BrennenJohnston/braille-cylinder-stl-generator-openscad/Braille_Cylinder_STL_Generator.scad

// Braille Cylinder STL Generator (OpenSCAD)
// Generates embossing plates and counter plates for cylindrical objects
//
// =============================================================================
// WHAT THIS MAKES
// =============================================================================
//  • Cylinder Emboss Plate (Raised Dots) — dots on outer cylinder surface
//  • Cylinder Counter Plate (Hemispherical Recesses) — recesses on outer surface
//
//  DOUBLE-SIDED CARD — set double_sided = On to emboss BOTH faces of one
//  card in a single pass between the two cylinders. The same two plates take on
//  paired jobs, and each one then carries raised dots AND recesses:
//  • Cylinder A = the Embossing Plate. The FRONT text as raised dots, plus one
//    recessed seat for every BACK dot the other cylinder raises.
//  • Cylinder B = the Counter Plate. The BACK text as raised dots, plus one
//    recessed seat for every FRONT dot Cylinder A raises.
//  Two things change in this mode. There is NO universal recess grid — every
//  recess is the 1:1 partner of an actual dot, so a seat can never sit under
//  this plate's own raised dot. And the row indicators are always TACTILE (the
//  raised seam arrows), because the paired seats occupy the ground the Visual
//  marker columns would stand on, and a blind user needs the arrow to tell the
//  two cylinders apart. Choosing Visual while double_sided is On is overridden,
//  and the model says so on the console and in red text above the cylinder.
//
// =============================================================================
// BEFORE YOU START
// =============================================================================
//  • Install OpenSCAD and open this .scad file
//  • In OpenSCAD, open View → Customizer to access all parameters
//  • This version requires pre-translated Unicode braille (no automatic translation)
//  • All parameters match the web-based generator UI for consistency
//
// =============================================================================
// TRANSLATE YOUR TEXT (REQUIRED) — BRANAH WORKFLOW
// =============================================================================
//  This OpenSCAD version does NOT include automatic translation. You must:
//  
//  1. Go to https://www.branah.com/braille-translator
//  2. In the options, select your desired braille grade:
//     - Grade 2 (contracted): Recommended for most uses
//     - Grade 1 (uncontracted): For names, emails, or when contractions cause confusion
//  3. Select Unicode Braille output (NOT ASCII Braille)
//  4. Type your English text in the left box
//  5. Copy the braille output (right box showing characters like ⠓⠑⠇⠇⠕)
//  6. In OpenSCAD's Customizer, paste into the Line_1, Line_2, etc. fields
//  7. DOUBLE-SIDED only — the back of the card is translated exactly the
//     same way: same site, same grade, Unicode Braille output. Paste that
//     output into the Back_Line_1, Back_Line_2, … fields under the
//     [Back of Card - Pre-Translated Braille] tab. Back lines obey the same
//     rules as the front — pre-translated Unicode braille only, same cell
//     capacity per row, same row limit — and the same warnings cover them.
//
//  IMPORTANT: If you paste ordinary English letters or see "INVALID CHARACTERS"
//  warning, re-translate on Branah and ensure Unicode Braille is selected.
//
// =============================================================================
// QUICK START GUIDE
// =============================================================================
//  1. Translate your text at https://www.branah.com/braille-translator
//  2. Paste pre-translated braille into Line_1, Line_2, etc.
//  3. Raise grid_rows to at least the number of lines you filled in — only the
//     first grid_rows lines are rendered, and a "TOO MANY LINES" warning tells
//     you when text is being left off. Lines 9 and 10 live under the
//     [More Braille Lines (Advanced)] tab.
//  4. Both cylinders render side by side by default: Cylinder A (the Embossing
//     Plate) on the left, Cylinder B (the Counter Plate) on the right. For one
//     plate, set render_both_plates Off under
//     [Expert Mode - Cylinders to Generate] and choose plate_type.
//  5. Choose dot_shape: Rounded or Cone (affects both plates)
//  6. Adjust dimensions in Expert Mode if needed
//  7. Render (F6) → File → Export → STL
//  8. DOUBLE-SIDED: turn double_sided On and fill the Back_Line fields. One
//     render builds both cylinders; export it as Cylinder_Pair_<your name>.stl.
//     For separate files, set render_both_plates Off and render each
//     plate_type once — export the Embossing Plate as
//     Cylinder_A_<your name>.stl and the Counter Plate as
//     Cylinder_B_<your name>.stl. The console prints the suggested name for
//     whichever plate you are rendering.
//
// =============================================================================
// PARAMETER ORGANIZATION
// =============================================================================
//  The Customizer follows the web-based generator's layout: its sections in
//  its top-down order, under its names, and every dial the web app keeps in
//  Expert Mode under an "Expert Mode - " tab. tests/test_customizer_layout.py
//  pins the order; when the web app's layout changes, this file follows.
//
//  MAIN CONTROLS, the web app's Embosser setup and text entry:
//  • Gears (the integrated_gears switch)
//  • Card Sides (the double_sided switch)
//  • Text Input - Pre-Translated Braille (Line_1 - Line_8)
//  • More Braille Lines (Advanced) (Line_9 - Line_10, the grid_rows maximum)
//  • Back of Card - Pre-Translated Braille (Back_Line_1 - Back_Line_10)
//
//  EXPERT MODE, the web app's Expert Mode submenus in its order:
//  • Expert Mode - Cylinders to Generate (both cylinders by default, or one
//    plate, and the print spacing between them)
//  • Expert Mode - Card Thickness (the 0.4mm and 0.3mm card presets, or Custom)
//  • Expert Mode - Row Indicator Style (Visual markers or the Tactile seam
//    arrow, and the arrow's sizes)
//  • Expert Mode - Shape Selection (dot shapes, indicators)
//  • Expert Mode - Braille Spacing (grid layout, positioning and the TEXT TOO
//    LONG check)
//  • Expert Mode - Braille Dot Adjustments (emboss/counter dimensions)
//  • Expert Mode - Surface Dimensions (including the slicer seam channel)
//
//  OPENSCAD-SPECIFIC, after the web app's sections (no web app dial):
//  • Expert Mode - Card Sides (the two interpoint offsets; the web app keeps
//    them at 1.25 mm)
//  • Expert Mode - Rendering Quality
//
// =============================================================================
// REFERENCES
// =============================================================================
//  [1] Web-based Generator (with automatic translation): 
//      https://github.com/BrennenJohnston/braille-cylinder-stl-generator
//      https://braille-cylinder-stl-generator.vercel.app
//  [2] Branah Braille Translator: https://www.branah.com/braille-translator
//  [3] BANA — Size and Spacing: https://brailleauthority.org/size-and-spacing-braille-characters
//  [4] NLS — Specification 800: https://www.loc.gov/nls/
//  [5] 2010 ADA Standards: https://archive.ada.gov/
//
// =============================================================================
// ACKNOWLEDGMENTS
// =============================================================================
//  This OpenSCAD version is based on the web-based generator by Brennen Johnston.
//  Special thanks to Tobi Weinberg for the substantial time and effort volunteered
//  to help start the original project.
//
//  Original web app powered by Liblouis, an open-source professional braille
//  translator: https://liblouis.io/
// =============================================================================

/* [Gears] */
// Makes each cylinder one solid piece with its top and bottom gears; needs the assets folder beside this file. Fixed gears fit only the Version 1 fixed-gear housing; the standard housing takes the standard cylinders.
integrated_gears = "Off"; // [Off, On]

/* [Card Sides] */
// On embosses both faces of the card in one pass; the back's braille goes in the Back of Card group. Each cylinder then carries raised dots and recesses, and the rows get the tactile arrows.
double_sided = "Off"; // [Off, On]

/* [Text Input - Pre-Translated Braille] */
// Paste Unicode braille characters from www.branah.com/braille-translator
Line_1 = "⠓⠑⠇⠇⠕"; // First line of braille text
Line_2 = "⠺⠕⠗⠇⠙"; // Second line of braille text
Line_3 = ""; // Third line of braille text
Line_4 = ""; // Fourth line of braille text
Line_5 = ""; // Fifth line of braille text
Line_6 = ""; // Sixth line of braille text
Line_7 = ""; // Seventh line of braille text
Line_8 = ""; // Eighth line of braille text

/* [More Braille Lines (Advanced)] */
// Lines 9 and 10 reach the grid_rows maximum of 10. The Customizer cannot add fields on demand, so these live in their own tab rather than lengthening the text input above. Raise grid_rows under [Expert Mode - Braille Spacing] to match, and give the cylinder the height to hold them: 10 rows at the default 10 mm line_spacing needs about 100 mm.
Line_9 = ""; // Ninth line of braille text
Line_10 = ""; // Tenth line of braille text

/* [Back of Card - Pre-Translated Braille] */
// All ten rows live in this tab, unlike the front's 8 + 2 split. That split
// exists to keep the always-visible main text tab at eight fields; this tab is
// opt-in, so splitting it would only send a double-sided user to a second tab -
// one that also holds single-sided fields - to finish one job.

// The back of the card, one row per field, in the same order as the front: Unicode braille, translated the same way. Used only while double sided is On.
Back_Line_1 = ""; // First line of back-of-card braille text
Back_Line_2 = ""; // Second line of back-of-card braille text
Back_Line_3 = ""; // Third line of back-of-card braille text
Back_Line_4 = ""; // Fourth line of back-of-card braille text
Back_Line_5 = ""; // Fifth line of back-of-card braille text
Back_Line_6 = ""; // Sixth line of back-of-card braille text
Back_Line_7 = ""; // Seventh line of back-of-card braille text
Back_Line_8 = ""; // Eighth line of back-of-card braille text
Back_Line_9 = ""; // Ninth line of back-of-card braille text
Back_Line_10 = ""; // Tenth line of back-of-card braille text

/* [Expert Mode - Cylinders to Generate] */
// On builds Cylinder A (left) and Cylinder B (right) in one file, spaced for one print plate. Off builds only the one that plate type names.
render_both_plates = "On"; // [Off, On]
// Choose which plate to generate while render_both_plates above is Off. In DOUBLE-SIDED mode the two names take on the paired roles the web app uses: "Embossing Plate" IS Cylinder A and "Counter Plate" IS Cylinder B, exported as Cylinder_A_*.stl and Cylinder_B_*.stl. Single-sided keeps these names exactly as they are.
plate_type = "Embossing Plate"; // [Embossing Plate, Counter Plate]
// Gap between the two cylinders' surfaces (mm) - PRINT spacing only, not the meshed-gear assembly distance (32.0473 mm axis to axis); a printed pair is separated for assembly anyway. With Integrated Gears On, the gear tips overhang the barrel by 0.71 mm each side, so the tip-to-tip gap comes out about 1.4 mm less than this number.
pair_spacing_mm = 10; // [2:1:50]

/* [Expert Mode - Card Thickness] */
// Preset optimized for card thickness (sets multiple parameters below)
paper_thickness_preset = "0.4mm"; // [0.4mm, 0.3mm, Custom]

/* [Expert Mode - Row Indicator Style] */
// Visual (default): a recessed triangle, plus the optional letter square, at the start of each row. Tactile: a raised arrow on Cylinder A and a matching recess on Cylinder B, found by touch; uses no braille cells.
indicator_mode = "Visual"; // [Visual, Tactile]
// Tactile only: indicator width measured around the cylinder (mm)
tactile_indicator_width = 4.0; // [2:0.1:10]
// Tactile only: indicator length measured along the cylinder axis (mm). The default is long enough for a fingertip to read the direction of the point in one pass; at the 10 mm default line_spacing it also means each row's arrow meets the base of the one above.
tactile_indicator_length = 10.0; // [2:0.1:15]
// Tactile only: how far the embossing plate's arrow stands proud of the surface (mm). Keep this BELOW the braille dot height so the dots — not the indicator — carry the rolling pressure. It also sets the wall: a deeper raise means a deeper counter-plate recess, and the material left between that recess floor and the polygonal cutout gets thinner. 1.2 mm is the printable floor, and the model warns on the console and in red 3D text below it.
tactile_indicator_raise = 0.5; // [0:0.1:2]
// Tactile only: outline margin added around the counter plate's recess (mm), so the arrow still enters the recess when the two cylinders are slightly misaligned.
tactile_recess_clearance = 0.2; // [0:0.05:1]
// Tactile only: counter recess depth added on top of the arrow raise (mm). 0 = exact same-depth nesting. Large values thin the wall between the recess and the polygonal cutout.
tactile_recess_extra_depth = 0.2; // [0:0.05:1]

/* [Expert Mode - Shape Selection] */
// Braille Dot Shape (Emboss and Counter) - affects both plate types (Rounded is the default for the 0.4mm and 0.3mm presets)
dot_shape = "Rounded"; // [Rounded, Cone]
// Indicator Letters (Emboss and Counter) - VISUAL INDICATOR MODE ONLY (Tactile mode has no marker cells and ignores this). Square marker cutout next to the alignment triangle. Off frees 1 cell per row for braille text; the triangle alignment indicators are always included (they are critical to the mechanical device the cylinder mounts into).
indicators = "On"; // [On, Off]

/* [Expert Mode - Braille Spacing] */
// --- Braille Dimensions ---

// Text capacity in braille cells per row (matches the web app default of 13 text cells; in Visual indicator mode, 2 extra marker cells are added when Indicator Letters are On, or 1 extra cell for the always-present alignment triangle when Off — up to 14 text cells fit the default cylinder with Indicator Letters Off. Tactile indicator mode adds no marker cells, so 14 text cells fit the default cylinder, but a 90 mm card loaded at the alignment arrow holds only 13 - 14 run off its end, and the model says so; 15 leaves too little seam gap for the indicator)
grid_columns = 13; // [1:1:20]
// Number of lines of braille
grid_rows = 4; // [1:1:10]
// Horizontal spacing between cells (mm)
cell_spacing = 6.5; // [2:0.1:15]
// Vertical spacing between lines (mm)
line_spacing = 10.0; // [5:0.1:25]
// Spacing between dots within a cell (mm)
dot_spacing = 2.5; // [1:0.1:5]

// --- Braille Positioning ---

// Vertical adjustment of braille pattern (mm). Note: on a cylinder, X = angular wrap around the seam — a linear "X adjust" has no useful meaning, so only the vertical adjust is exposed.
braille_y_adjust = 0.0; // [-10:0.1:10]
// Show TEXT TOO LONG warning and clip rows to the cell capacity. Off = render every pasted character (rows may crowd the seam).
text_limit_check = "On"; // [On, Off]

/* [Expert Mode - Braille Dot Adjustments] */
// --- Embossing Braille Dot Dimensions (Rounded Shape) ---

// Rounded dot base diameter (cone base) (mm)
rounded_dot_base_diameter = 1.5; // [0.5:0.1:3]
// Rounded dot base height (cone height) (mm)
rounded_dot_base_height = 0.5; // [0:0.1:2]
// Rounded dome diameter (linked to cone flat top) (mm)
rounded_dot_dome_diameter = 1.0; // [0.5:0.1:3]
// Rounded dot dome height (mm)
rounded_dot_dome_height = 0.5; // [0.1:0.1:2]

// --- Embossing Braille Dot Dimensions (Cone Shape) ---

// Cone dot base diameter (mm)
emboss_dot_base_diameter = 1.5; // [0.5:0.1:3]
// Cone dot height (mm)
emboss_dot_height = 0.8; // [0.3:0.1:2]
// Cone dot flat hat diameter (mm)
emboss_dot_flat_hat = 0.4; // [0.1:0.1:2]

// --- Counter Braille Recessed Dot Dimensions (Rounded Shape / Bowl) ---

// Bowl recess base diameter (mm)
bowl_counter_dot_base_diameter = 1.8; // [0.5:0.1:5]
// Bowl recess depth (mm)
counter_dot_depth = 0.8; // [0.1:0.1:2]

// --- Counter Braille Recessed Dot Dimensions (Cone Shape) ---

// Cone recess base diameter (mm)
cone_counter_dot_base_diameter = 1.9; // [0.5:0.1:3]
// Cone recess height (mm)
cone_counter_dot_height = 0.7; // [0.3:0.1:2]
// Cone recess flat hat diameter (mm)
cone_counter_dot_flat_hat = 1.0; // [0.1:0.1:2]

/* [Expert Mode - Surface Dimensions] */
// Cylinder outer diameter in mm
cylinder_diameter_mm = 30.8; // [10:0.1:100]
// Cylinder height in mm
cylinder_height_mm = 52; // [20:1:150]
// Polygonal cutout circumscribed radius (0 = no cutout)
polygon_cutout_radius_mm = 13.0; // [0:0.1:50]
// Number of sides/points for polygonal cutout
polygon_cutout_points = 12; // [3:1:24]
// Seam offset (degrees) — Turns the polygonal cutout around the cylinder's axis. The braille does not move.
seam_offset_degrees = 0.0; // [0:1:360]

// Slicer seam channel (OpenSCAD parity plan phase O1, 2026-09-21; web decisions
// D-1, D-2, D-13..D-15). Size is not a dial: the six SEAM_CHANNEL_* constants
// below the sync marker mirror the web generator's app/geometry_spec.py and
// tests/test_seam_channel_scad.py diffs them. The description below is the
// web generator's note for the same switch (its string S-C1), kept identical.

// A shallow groove beside the row markers where the slicer hides its layer seam, keeping it off the dots. Turn Off for a plain surface.
seam_channel = "On"; // [On, Off]

/* [Expert Mode - Card Sides] */
// How far the back grid is shifted from the front grid, so a front dot and a back dot never land on the same patch of paper and flatten each other. The shift is diagonal: this is the part measured AROUND the cylinder (mm). The 1.25 / 1.25 default is the industry interpoint offset and the value the printed pairs were validated at; the 1.15-1.35 range is enforced, and a value outside it stops the render.
interpoint_offset_x_mm = 1.25; // [1.15:0.01:1.35]
// The other half of the same diagonal shift, measured ALONG the cylinder axis (mm) - back rows sit this far above the front rows.
interpoint_offset_y_mm = 1.25; // [1.15:0.01:1.35]

/* [Expert Mode - Rendering Quality] */
// Sphere quality for rounded shapes
render_quality = "Medium"; // [Low, Medium, High]
// Cone segments for cone shapes (8-32 range recommended)
cone_segments = 16; // [8:1:64] Number of segments for cone shapes

/* [Hidden] */
$fn = 32; // Resolution for curved surfaces

// Mathematical constants
PI = 3.14159265359;

// Preset value tables (PRESET_04, PRESET_03) and the preset_value() lookup
// helper live in presets.scad. Edit that file to change preset values.
include <presets.scad>;

// =============================================================================
// DOUBLE-SIDED (INTERPOINT) MATH
// =============================================================================
//
// Double-sided ("interpoint") mode embosses BOTH faces of one card in a single
// pass between two counter-rotating cylinders. Each cylinder then carries raised
// dots (its own face's braille) AND recesses (to receive the other cylinder's
// dots) on the same surface. The back grid is shifted diagonally - the industry
// "interpoint" offset - so a front dot and a back dot never land on the same
// patch of paper and flatten each other.
//
// This section is the MATH: constants, pure functions, self-checks and range
// guards. The geometry that reads them lives further down, in
// ds_back_placements() and the two plate modules. The user-facing controls -
// `double_sided`, `Back_Line_1..10` and the two interpoint offsets - are in the
// [Card Sides], [Back of Card - Pre-Translated Braille] and
// [Expert Mode - Card Sides] Customizer tabs near the top of this file; the gate
// defaults to "Off", and with it Off nothing here changes a single byte of the
// rendered model.
//
// Ported from the web generator's app/geometry/interpoint.py, which stays the
// authoritative implementation. The numbers are the approved 2026-08-16
// interpoint research decisions D1/D2/D3, recorded next to each constant.
//
// PLACEMENT: this block sits ABOVE the BACKWARD COMPATIBILITY marker on purpose.
// Everything from that marker to EOF must stay byte-identical to the MakerWorld
// flattened build (tests/test_makerworld_sync.py), and that build is re-flattened
// in its own phase. Anything added below the marker breaks that guard - which is
// also why the Customizer tabs above hold the parameters, and this block holds
// only what derives from them.

/* [Hidden] */
// Print the self-check echoes below. Off in normal renders so scripts\scad-check.ps1
// stays quiet; tests/test_interpoint_math_scad.py renders with this On. A test
// hook, not a user control, so it stays out of the Customizer.
ds_self_check = false;

// Normalized gate for the `double_sided` dropdown declared in the
// [Card Sides] tab. Accepts the Customizer's "On"/"Off" and the
// lowercase "on"/"off" the test system passes with -D, the same way plate_type
// and dot_shape accept both the label and a lowercase form. Declared here rather
// than beside is_emboss_plate / tactile_on in CALCULATED VALUES because that
// section lives past the MakerWorld sync marker.
ds_on = (double_sided == "On") || (double_sided == "on");

// Normalized gate for the `integrated_gears` dropdown, read exactly the way
// ds_on reads its own: the Customizer sends "On"/"Off" and the test system
// passes lowercase with -D. Deliberately NOT a preset-owned key, so -D reaches
// it headlessly (a -D on a preset-owned key silently loses and the render still
// looks fine).
gears_on = (integrated_gears == "On") || (integrated_gears == "on");

// Gear mode only: grow the RAISED tactile arrow's outline by 5 um. At the
// default 10 mm indicator length on 10 mm line spacing each arrow's apex
// touches the next arrow's base exactly, and float32 STL rounding welds that
// tangency into a non-manifold pinch edge - which would break the watertight
// one-piece roller. Physically negligible: 2.5% of the recess nesting
// clearance, far below print accuracy. Off, the outline is untouched, so
// existing exports keep the tangency they ship with.
GEAR_ARROW_WELD_MM = 0.005;

// Back-face counterpart of _all_lines, under the same contract: the single
// source of truth for the back content, so no geometry ever names a Back_Line_N.
_all_back_lines = [Back_Line_1, Back_Line_2, Back_Line_3, Back_Line_4, Back_Line_5,
                   Back_Line_6, Back_Line_7, Back_Line_8, Back_Line_9, Back_Line_10];

// -----------------------------------------------------------------------------
// D1 - THE INTERPOINT OFFSET
// -----------------------------------------------------------------------------
// The back grid sits 1.25 mm diagonally from the front grid. Source: US Patent
// 5,527,117 (Roy, Impact Devices, 1996). Sweeping the fully-populated
// 2.5 / 6.5 / 10.0 lattice confirms the diagonal is the optimum: it maximises the
// smallest front-to-back centre distance, at 1.767767 mm.
DS_OFFSET_MIN_MM = 1.15;  // smallest offset the guards below accept, mm
DS_OFFSET_MAX_MM = 1.35;  // largest offset the guards below accept, mm
// The peak of that sweep, and the default both offset sliders ship at. Clearance
// falls off SYMMETRICALLY either side of it - 1.15 and 1.35 measure the same
// 1.626 mm - so "move back toward this number" is the fix whichever end of the
// range a user has strayed to. Named here so the guard message below cannot
// drift from the value the sliders actually default to.
DS_OFFSET_OPTIMUM_MM = 1.25;

// -----------------------------------------------------------------------------
// D3 - WHICH WAY THE BACK GRID SHIFTS
// -----------------------------------------------------------------------------
// +1 = the back grid slides toward the END of the line; its features land LEFT
// of Cylinder A's raised arrows, seen from outside the cylinder with the top up.
// Physically confirmed 2026-08. If a printed pair ever crowds the unexpected
// side of the arrow, FLIP THIS SIGN FIRST - no clearance number can catch a
// wrong choice, because both signs measure exactly the same distances (the set
// of front-minus-back difference vectors already holds every vector and its
// negative).
DS_BACK_DIRECTION = 1;

// -----------------------------------------------------------------------------
// D2 - DOUBLE-SIDED FOOTPRINTS, "OPTION B"
// -----------------------------------------------------------------------------
// Double-sided needs smaller dots than single-sided, because raised dots and
// recesses now share one surface. At the shipped single-sided sizes only
// 0.118 mm of material is left between neighbours - below the 0.34 mm a 0.4 mm
// nozzle can print. Single-sided keeps today's sizes.
//
// These ship FIXED - no Customizer dials (2026-08-16) - as TWO packages keyed
// to paper_thickness_preset (Brennen 2026-08-20, research memory FD-8/FD-9):
// the print matrix showed one footprint cannot serve both card stocks. "0.3mm"
// is Option B, validated on 0.3 mm stock 2026-08-17 (nominal gap 0.518);
// anything else - the "0.4mm" default, and "Custom", which has no
// double-sided meaning - is Q2, the matrix winner validated on 0.4 mm stock
// 2026-08-20 (nominal gap 0.468, below the 0.50 reliable line BY DESIGN: the
// printed 0.428 mm ridge was measured printing clean). Keep in lockstep with
// the web repo's app/geometry/interpoint.py DS_FOOTPRINTS_BY_PRESET; the
// tests here pin both packages. Die heights above 1.0 mm scrape the
// embosser's cylinder-holder housing - never raise them without Brennen.
//
// There is deliberately NO dial and NO fallback switch. The rejected
// alternative, "Option A" (dot base dia 1.5 with the 1.3 bowl), leaves a
// 0.368 mm ridge - under the 0.50 mm reliable line and close to the 0.34 mm
// floor - and survives only as documented history in the web repo's
// docs/specifications/INTERPOINT_DOUBLE_SIDED_SPECIFICATIONS.md. Reviving it
// would be a new decision, not a setting.
ds_use_03_package = (paper_thickness_preset == "0.3mm");
DS_DOT_BASE_DIA = 1.2;                            // both packages, mm
DS_DOT_BASE_H   = ds_use_03_package ? 0.4 : 0.5;  // raised dot base height, mm
DS_DOT_DOME_DIA = ds_use_03_package ? 0.8 : 1.0;  // dome diameter at the base, mm
DS_DOT_DOME_H   = ds_use_03_package ? 0.4 : 0.5;  // dome height, mm - total dot 0.8 / 1.0
DS_BOWL_DIA     = ds_use_03_package ? 1.3 : 1.4;  // paired recess opening diameter, mm
DS_BOWL_DEPTH   = 0.5;                            // both packages, mm

// Derived from the six numbers above, so editing one of them moves the geometry
// with it and no size is ever written twice.
DS_DOT_HEIGHT = DS_DOT_BASE_H + DS_DOT_DOME_H;   // total raised dot height, mm

// Dome and bowl are both spherical caps: R = (a^2 + h^2) / (2h) for an opening
// radius a and a height/depth h. Same formula the single-sided dot and the
// counter plate's bowl already use.
DS_DOT_DOME_R = ((DS_DOT_DOME_DIA / 2) * (DS_DOT_DOME_DIA / 2) + DS_DOT_DOME_H * DS_DOT_DOME_H)
                / (2 * DS_DOT_DOME_H);
DS_BOWL_R     = ((DS_BOWL_DIA / 2) * (DS_BOWL_DIA / 2) + DS_BOWL_DEPTH * DS_BOWL_DEPTH)
                / (2 * DS_BOWL_DEPTH);

// WHAT THE BOWL ACTUALLY IS, and why DS_BOWL_DEPTH is not its depth.
//
// The bowl's sphere is centred ON the shell surface, not outside it, so the cut
// is a HEMISPHERE of radius DS_BOWL_R:
//
//     printed depth = DS_BOWL_R          (NOT DS_BOWL_DEPTH)
//     printed mouth = 2 * DS_BOWL_R      (NOT DS_BOWL_DIA)
//
// At the 0.3 package's 1.3 / 0.5 that is 0.6725 mm deep and 1.345 mm across; at
// the 0.4 package's 1.4 / 0.5 it is 0.7400 mm deep and 1.480 mm across. DS_BOWL_DIA
// and DS_BOWL_DEPTH are shape inputs to DS_BOWL_R above and nothing more; any sum
// computed from them directly is wrong. Note DS_BOWL_R is MINIMISED at
// DS_BOWL_DEPTH = DS_BOWL_DIA / 2, so over part of the range raising the depth
// makes the printed bowl SHALLOWER (0.5 -> 0.70 goes 0.6725 -> 0.6518 mm).
//
// This matches static/workers/csg-worker-manifold.js in the web repo
// (radialOffset = cylRadius), which is the authoritative convention by Brennen's
// decision of 2026-08-19: it is the geometry that has actually been printed and
// embossed. The web app's own Python renderer, and the SINGLE-SIDED
// counter_recess() below, both use the other convention - centre (R - depth)
// outside the surface, cut exactly the nominal depth. Single-sided is
// deliberately left alone: changing it would move every counter plate in use.

// Printability thresholds for the material left between a raised dot and a
// neighbouring recess on the same surface (Bambu X1C, 0.4 mm nozzle: Arachne
// widens anything from 0.1 to 0.34 mm up to 0.34 mm, and drops anything below
// 0.1 mm entirely). Those Arachne figures justify the FLOOR. They have never
// justified the reliable line.
//
// DS_GAP_RELIABLE is PROVISIONAL at 0.45 (Brennen, 2026-08-23), lowered from
// 0.50 to match the web app. 0.50 had no stated basis in either generator or in
// any spec, and it put the shipped 0.4 package (0.4678 mm nominal) permanently
// in warning in the WEB app - a standing warning an NVDA walkthrough found, and
// the kind that teaches a user to ignore warnings. It is NOT a measured value:
// the two data points that exist (0.4953 and 0.4278 mm printed) BOTH PASSED,
// and two passing samples cannot locate a failure boundary - they prove only
// that it lies below 0.4278. A print test that walks the gap down until the
// ridge visibly fails is what should set this number.
DS_GAP_RELIABLE = 0.45;   // provisional, unmeasured - see above, mm
DS_GAP_FLOOR    = 0.34;   // hard minimum, enforced by the guard below, mm

// The crowding line the PHYSICAL "DOTS TOO CLOSE" text (past the sync marker)
// fires at. ONE line for both packages, since 2026-08-23.
//
// It used to be `ds_use_03_package ? DS_GAP_RELIABLE : DS_GAP_FLOOR` - ratified
// by Brennen 2026-08-20 - because the 0.4 package sat below a 0.50 mm reliable
// line by design, so pointing the warning at that line would have nagged about
// the default package on every render. The split retired the text for the 0.4
// package entirely. With the reliable line re-decided at 0.45 the 0.4 package
// (0.4678 nominal) clears it honestly, so the workaround has nothing left to
// work around, and Brennen chose on 2026-08-23 to drop it so this generator and
// the web app warn at the same number instead of two.
//
// BEHAVIOUR CHANGE for existing users of the 0.4 package: the text can now
// appear in the 0.34-0.45 mm nominal band, where it was previously silent. That
// band is reachable by moving interpoint_offset_x/y_mm away from 1.25.
//
// The assert - and only the assert - measures the printed ridge (FD-11b,
// 2026-08-20); that is unchanged. The warning stays on the nominal figure so it
// keeps reporting the same number as the web app's checkDoubleSidedGap.
DS_GAP_ACCEPTED = DS_GAP_RELIABLE;

// Axial step between the front rows and the back rows: back rows sit 1.25 mm
// higher than front rows. Same number as the interpoint_offset_y_mm default, and
// unused by the maths in this phase - it is the nominal the row placement in a
// later phase builds on.
DS_AXIAL_STEP = 1.25;

// -----------------------------------------------------------------------------
// THE REFERENCE LATTICE THE CLEARANCE SWEEP RUNS ON
// -----------------------------------------------------------------------------
// Mirrors of the canonical grid defaults, not a new source: the same
// 2.5 / 6.5 / 10.0 mm the braille spacing sliders default to. Interpoint offsets
// the back grid; it never re-spaces braille. These are deliberately constants
// rather than reads of active_dot_spacing and friends, so the reported clearance
// is always the documented worst case - the same number interpoint.py reports.
DS_DOT_PITCH  = 2.5;      // dot-to-dot inside one cell, mm
DS_CELL_PITCH = 6.5;      // cell-to-cell along a row, mm
DS_LINE_PITCH = 10.0;     // row-to-row, mm

// Sweep bounds, matching interpoint.py's TACTILE_COLUMNS and GRID_ROWS. The
// answer does not actually depend on them - the closest pair is always inside a
// single cell - but they are pinned so this file and the web repo report the
// same number from the same sweep.
DS_LATTICE_COLS = 14;
DS_LATTICE_ROWS = 4;

// The fixed dot map, [row, col] for dots 1-6. Identical to `dot_positions` in
// the geometry section; declared separately only because that one lives past the
// MakerWorld sync marker. Never reorder either copy.
DS_DOT_MAP = [[0, 0], [1, 0], [2, 0], [0, 1], [1, 1], [2, 1]];

// -----------------------------------------------------------------------------
// PURE FUNCTIONS
// -----------------------------------------------------------------------------

// Every dot position of a fully-populated grid: all six dots of every cell of
// every row, as [x, y] in mm, x along the row and y up the cylinder. This is the
// worst case for same-surface crowding - real text never fills every position,
// but a counter plate's recesses may, and a user can type text that does.
function ds_lattice_points(cols       = DS_LATTICE_COLS,
                           rows       = DS_LATTICE_ROWS,
                           dot_pitch  = DS_DOT_PITCH,
                           cell_pitch = DS_CELL_PITCH,
                           line_pitch = DS_LINE_PITCH) =
    let (col_offsets = [-dot_pitch / 2, dot_pitch / 2],
         row_offsets = [dot_pitch, 0, -dot_pitch])
    [ for (col = [0 : cols - 1])
        for (row = [0 : rows - 1])
          for (d = DS_DOT_MAP)
            [ col * cell_pitch + col_offsets[d[1]],
              -row * line_pitch + row_offsets[d[0]] ] ];

// Smallest centre-to-centre distance, in mm, between a front feature and a back
// one. The back lattice is the front lattice mirrored and then translated, but a
// fully-populated grid is symmetric about its own centre, so the mirror maps it
// onto itself and the worst case reduces to a pure translation by the interpoint
// offset. DS_BACK_DIRECTION is applied so the code says which way the back grid
// goes; it provably cannot change the answer (see D3 above).
function ds_lattice_min_center_distance(offx, offy,
                                        cols       = DS_LATTICE_COLS,
                                        rows       = DS_LATTICE_ROWS,
                                        dot_pitch  = DS_DOT_PITCH,
                                        cell_pitch = DS_CELL_PITCH,
                                        line_pitch = DS_LINE_PITCH) =
    let (pts     = ds_lattice_points(cols, rows, dot_pitch, cell_pitch, line_pitch),
         shift_x = DS_BACK_DIRECTION * offx,
         shift_y = DS_BACK_DIRECTION * offy)
    sqrt(min([ for (b = pts)
                 min([ for (f = pts)
                         let (dx = f[0] - (b[0] + shift_x),
                              dy = f[1] - (b[1] + shift_y))
                         dx * dx + dy * dy ]) ]));

// Material left between a raised dot and its nearest neighbouring recess, in mm.
// Both live on the same cylinder surface: one face's raised dots and the recesses
// that receive the other face's dots. NEGATIVE means the two footprints overlap
// and the printed ridge between them does not exist. Compare against
// DS_GAP_RELIABLE (0.45 mm, provisional) and DS_GAP_FLOOR (0.34 mm).
function ds_same_surface_min_gap(dot_dia, recess_dia, offx, offy,
                                 cols       = DS_LATTICE_COLS,
                                 rows       = DS_LATTICE_ROWS,
                                 dot_pitch  = DS_DOT_PITCH,
                                 cell_pitch = DS_CELL_PITCH,
                                 line_pitch = DS_LINE_PITCH) =
    ds_lattice_min_center_distance(offx, offy, cols, rows, dot_pitch, cell_pitch, line_pitch)
    - (dot_dia + recess_dia) / 2;

// -----------------------------------------------------------------------------
// SELF-CHECKS
// -----------------------------------------------------------------------------
// Values with known answers, so a change to the maths above is caught at
// once instead of silently shifting every clearance. Printed only when
// ds_self_check is true, and independent of double_sided - the functions are
// pure, so they can be checked with the feature Off.
// tests/test_interpoint_math_scad.py renders with -D ds_self_check=true and
// asserts every expected key to +/-0.001 mm.
//   gap_package_03    Option B (dot 1.2, bowl 1.3) - above the reliable line
//   gap_package_04    Q2 (dot 1.2, bowl 1.4) - marginal BY DESIGN; the printed
//                     0.428 mm ridge was measured clean 2026-08-20
//   gap_active        the same gap for the ACTIVE preset's package
//   gap_active_printed  the SAME gap measured on the bowl's PRINTED mouth
//                     (2 * DS_BOWL_R) instead of its nominal diameter. The bowl
//                     is cut as a hemisphere centred on the surface, so its
//                     mouth is wider than DS_BOWL_DIA and the real ridge is
//                     narrower than every gap above it: 0.495 mm for the 0.3
//                     package where the nominal says 0.518, and 0.428 mm for
//                     the 0.4 package where the nominal says 0.468. The
//                     printability ASSERT measures this number (Brennen's
//                     decision 2026-08-20); the DOTS TOO CLOSE text keeps
//                     reporting the nominal, so it stays the same figure the
//                     web app's checkDoubleSidedGap and app/geometry_spec.py
//                     show. Echoed at the fixed 1.25 / 1.25 reference offsets,
//                     like every gap above it - the guard's own live value is
//                     ds_printed_ridge_mm, further down.
//   gap_single_sided  the web app's single-sided sizes - the documented failure
//                     case, below the 0.34 mm floor
//   gap_legacy_cone   the legacy cone footprints - negative, i.e. overlapping
// The four values after them are the derived footprint geometry the paired dot
// and recess are actually built from, echoed so the cut depth this file produces
// can be cited without opening a mesh.
if (ds_self_check) {
    echo("DS_SELFCHECK: every value below is mm");
    echo(str("DS_SELFCHECK lattice_1_25_1_25=", ds_lattice_min_center_distance(1.25, 1.25)));
    echo(str("DS_SELFCHECK lattice_1_25_0=",    ds_lattice_min_center_distance(1.25, 0)));
    echo(str("DS_SELFCHECK gap_package_03=",    ds_same_surface_min_gap(1.2, 1.3, 1.25, 1.25)));
    echo(str("DS_SELFCHECK gap_package_04=",    ds_same_surface_min_gap(1.2, 1.4, 1.25, 1.25)));
    echo(str("DS_SELFCHECK gap_active=",        ds_same_surface_min_gap(DS_DOT_BASE_DIA, DS_BOWL_DIA, 1.25, 1.25)));
    echo(str("DS_SELFCHECK gap_active_printed=", ds_same_surface_min_gap(DS_DOT_BASE_DIA, 2 * DS_BOWL_R, 1.25, 1.25)));
    echo(str("DS_SELFCHECK gap_single_sided=",  ds_same_surface_min_gap(1.5, 1.8, 1.25, 1.25)));
    echo(str("DS_SELFCHECK gap_legacy_cone=",   ds_same_surface_min_gap(1.8, 1.8, 1.25, 1.25)));
    echo(str("DS_SELFCHECK dot_height=",         DS_DOT_HEIGHT));
    echo(str("DS_SELFCHECK dot_dome_r=",         DS_DOT_DOME_R));
    echo(str("DS_SELFCHECK bowl_sphere_r=",      DS_BOWL_R));
    echo(str("DS_SELFCHECK bowl_printed_mouth=",  2 * DS_BOWL_R));
}

// The ridge the printability guard measures, at the user's ACTUAL offsets: the
// material left between a raised dot and its neighbouring recess, using the
// bowl's PRINTED mouth (2 * DS_BOWL_R) rather than its nominal diameter.
//
// Brennen's decision, 2026-08-20: the hard guard measures what actually prints.
// The bowl is cut as a hemisphere centred on the shell surface, so its mouth is
// wider than DS_BOWL_DIA and the nominal figure OVERSTATES the ridge - by
// 0.023 mm for the 0.3 package and 0.040 mm for the 0.4 package. That gap is
// exactly the band where the old nominal guard let through a ridge the printer
// cannot hold. The DOTS TOO CLOSE warning below deliberately still reports the
// nominal, matching the web app's checkDoubleSidedGap and app/geometry_spec.py;
// only the assert moved, so no warning threshold had to be re-decided.
//
// Consequence, measured: with the shipped 0.4 package the renderable offset band
// is 1.19-1.31 mm rather than the slider's full 1.15-1.35. The 0.3 package keeps
// the whole range (its worst case is 0.354 mm, still above the floor). Clearance
// peaks at DS_OFFSET_OPTIMUM_MM and falls off symmetrically, so both ends fail
// together and moving back toward the middle is always the fix.
ds_printed_ridge_mm = ds_on
    ? ds_same_surface_min_gap(DS_DOT_BASE_DIA, 2 * DS_BOWL_R,
                              interpoint_offset_x_mm, interpoint_offset_y_mm)
    : 0;

// -----------------------------------------------------------------------------
// GUARDS
// -----------------------------------------------------------------------------
// Active only when double_sided is On. A failed assert stops the render and
// fails scripts\scad-check.ps1 - that is the point. A pair printed outside these
// ranges will not register, and nothing in a rendered preview would show it.
if (ds_on) {
    assert(interpoint_offset_x_mm >= DS_OFFSET_MIN_MM &&
           interpoint_offset_x_mm <= DS_OFFSET_MAX_MM,
           "interpoint_offset_x_mm outside 1.15-1.35 range");
    assert(interpoint_offset_y_mm >= DS_OFFSET_MIN_MM &&
           interpoint_offset_y_mm <= DS_OFFSET_MAX_MM,
           "interpoint_offset_y_mm outside 1.15-1.35 range");
    assert(ds_printed_ridge_mm >= DS_GAP_FLOOR,
           str("double-sided dots and recesses too close to print: this offset ",
               "leaves only ", round(ds_printed_ridge_mm * 1000) / 1000,
               " mm of material between a raised dot and the recess beside it, ",
               "and ", DS_GAP_FLOOR, " mm is the printable minimum. Clearance is ",
               "widest with both interpoint offsets at ", DS_OFFSET_OPTIMUM_MM,
               " mm and narrows toward either end of the range, so move them ",
               "back toward ", DS_OFFSET_OPTIMUM_MM,
               " mm - or select the 0.3mm card stock preset, which pairs the ",
               "same dot with a smaller bowl and accepts the whole range."));
}

// =============================================================================
// BACKWARD COMPATIBILITY - Test System Parameters
// =============================================================================
// The automated test system passes parameters via -D flags using these names.
// These hidden parameters allow the test system to work without modification.
//
// Usage: openscad -D 'combined_shape="rounded"' -D 'indicator_shapes="on"' ...
//
// IMPORTANT: keep this `/* [Hidden] */` marker so OpenSCAD's Customizer
// never renders these four vars as orphan, uncategorized sliders even if
// a new `/* [Section] */` heading gets inserted above this block later.
/* [Hidden] */
combined_shape = "";         // "rounded" or "cone" (from test system)
indicator_shapes = "";       // "on" or "off" (from test system)
hemisphere_quality = "";     // "low", "medium", "high" (from test system)
shape_type = "";             // "cylinder" (from test system, ignored - cylinder only)

// =============================================================================
// CALCULATED VALUES (Do not modify)
// =============================================================================

// Normalize dropdown selections to internal values
// Support both UI dropdowns (human-friendly) and test system parameters (lowercase)
is_emboss_plate = (plate_type == "positive") ? true :
                  (plate_type == "negative") ? false :
                  (plate_type == "Embossing Plate");

// Both-plates mode: lowercase accepted the way the other toggles
// accept theirs from the test system. While On, plate_type is ignored and
// MAIN RENDERING at the bottom builds both cylinders side by side.
both_on = (render_both_plates == "On") || (render_both_plates == "on");

use_rounded_dots = (combined_shape == "rounded") ? true :
                   (combined_shape == "cone") ? false :
                   (dot_shape == "Rounded");

indicator_on = (indicator_shapes == "on") ? true :
               (indicator_shapes == "off") ? false :
               (indicators == "On");

// Tactile indicator mode replaces the recessed marker columns with a raised
// arrow (emboss) / matching recess (counter) in the seam gap. It supersedes
// `indicator_on`, which only ever gates the Visual letter square.
//
// Double-sided mode is always tactile. Its two cylinders carry 1:1 paired
// recesses across the whole surface, which is exactly where the Visual marker
// columns would sit, and a blind user working a double-sided pair needs the
// seam arrow to tell the two cylinders apart. The web app refuses the
// combination outright; here it is forced, and warned about below.
tactile_on = (indicator_mode == "Tactile") || ds_on;

// Set when that forcing actually overrode a user's choice, so it can be both
// echoed and rendered as 3D warning text.
ds_forced_tactile = ds_on && (indicator_mode != "Tactile");

if (ds_forced_tactile)
    echo(str("WARNING: double_sided is On, so indicator_mode \"", indicator_mode,
             "\" has been overridden and this plate renders with tactile seam ",
             "arrows. Set indicator_mode = Tactile to clear this."));

// Double-sided renders come in pairs, and the two STLs have to be told apart
// after export. The names match the web app's double-sided flow, whose downloads
// are Cylinder_A_*.stl and Cylinder_B_*.stl; single-sided filenames are never
// renamed. Deliberately not a WARNING: it is a hint, and scripts\scad-check.ps1
// treats that token as a failure.
// Gated on !both_on: in both-plates mode one file holds the
// pair, so the pair hint below speaks instead.
if (ds_on && !both_on)
    echo(str("Double-sided: this render is Cylinder ", is_emboss_plate ? "A" : "B",
             " (the ", is_emboss_plate ? "Embossing Plate" : "Counter Plate",
             "). Suggested export filename: Cylinder_", is_emboss_plate ? "A" : "B",
             "_<your name>.stl"));

// Both-plates mode: one render, one file, one suggested name. Deliberately
// not a WARNING - scripts\scad-check.ps1 treats that token as a failure.
if (both_on) {
    echo(str("Both plates: one STL containing Cylinder A / Embossing Plate (left) ",
             "and Cylinder B / Counter Plate (right), surfaces ", pair_spacing_mm,
             " mm apart. Suggested export filename: Cylinder_Pair_<your name>.stl"));
    echo("NOTE: render_both_plates is On, so plate_type is ignored and both cylinders render.");
}

// Material left between a raised dot and its nearest neighbouring recess, both
// of which share this surface in double-sided mode. The 336-point lattice sweep
// behind it is only paid for when the mode is on.
ds_same_surface_gap = ds_on
    ? ds_same_surface_min_gap(DS_DOT_BASE_DIA, DS_BOWL_DIA,
                              interpoint_offset_x_mm, interpoint_offset_y_mm)
    : 0;
// Below DS_GAP_FLOOR the guard in the DOUBLE-SIDED MATH section has already
// stopped the render, so this text only ever speaks in the band between the
// floor and DS_GAP_ACCEPTED. Since 2026-08-23 that is the same line for both
// packages (see the DOUBLE-SIDED MATH section); before then the 0.4 package
// used the floor instead, which retired this text for it entirely.
ds_dots_too_close = ds_on && (ds_same_surface_gap < DS_GAP_ACCEPTED);

// Map render quality to segment counts (support both UI and test system).
//
// The test override is ranked ABOVE the dropdown, not interleaved with it.
// Interleaved - the arms reading `hemisphere_quality == "low" || render_quality
// == "Low"` and so on - the override could not raise quality: with the shipped
// default render_quality "Medium" standing, `hemisphere_quality="high"` fell
// through arm 1, then matched "Medium" in arm 2 and silently rendered at 32.
// The 64 arm was unreachable. "low" and "medium" appeared to work only by
// accident ("medium" collides with the default's own answer), so the bug bit
// exactly the one value that disagrees with the default.
quality_fn = (hemisphere_quality == "low")    ? 24 :
             (hemisphere_quality == "medium") ? 32 :
             (hemisphere_quality == "high")   ? 64 :
             (render_quality == "Low")        ? 24 :
             (render_quality == "High")       ? 64 : 32;

// =============================================================================
// PRESET ROUTING - Select preset vs. custom values
// =============================================================================
// Each `_preset_*` variable routes between the matching preset table entry
// (see presets.scad) and the user's slider value. If `paper_thickness_preset`
// is "0.4mm" or "0.3mm", the table value wins; otherwise the slider value
// (third argument) is used.

// Spacing parameters
_preset_grid_columns                   = preset_value(paper_thickness_preset, "grid_columns",                   grid_columns);
_preset_grid_rows                      = preset_value(paper_thickness_preset, "grid_rows",                      grid_rows);
_preset_cell_spacing                   = preset_value(paper_thickness_preset, "cell_spacing",                   cell_spacing);
_preset_line_spacing                   = preset_value(paper_thickness_preset, "line_spacing",                   line_spacing);
_preset_dot_spacing                    = preset_value(paper_thickness_preset, "dot_spacing",                    dot_spacing);
_preset_braille_y_adjust               = preset_value(paper_thickness_preset, "braille_y_adjust",               braille_y_adjust);

// Emboss Rounded parameters
_preset_rounded_dot_base_diameter      = preset_value(paper_thickness_preset, "rounded_dot_base_diameter",      rounded_dot_base_diameter);
_preset_rounded_dot_base_height        = preset_value(paper_thickness_preset, "rounded_dot_base_height",        rounded_dot_base_height);
_preset_rounded_dot_dome_diameter      = preset_value(paper_thickness_preset, "rounded_dot_dome_diameter",      rounded_dot_dome_diameter);
_preset_rounded_dot_dome_height        = preset_value(paper_thickness_preset, "rounded_dot_dome_height",        rounded_dot_dome_height);

// Emboss Cone parameters
_preset_emboss_dot_base_diameter       = preset_value(paper_thickness_preset, "emboss_dot_base_diameter",       emboss_dot_base_diameter);
_preset_emboss_dot_height              = preset_value(paper_thickness_preset, "emboss_dot_height",              emboss_dot_height);
_preset_emboss_dot_flat_hat            = preset_value(paper_thickness_preset, "emboss_dot_flat_hat",            emboss_dot_flat_hat);

// Counter Bowl parameters
_preset_bowl_counter_dot_base_diameter = preset_value(paper_thickness_preset, "bowl_counter_dot_base_diameter", bowl_counter_dot_base_diameter);
_preset_counter_dot_depth              = preset_value(paper_thickness_preset, "counter_dot_depth",              counter_dot_depth);

// Counter Cone parameters
_preset_cone_counter_dot_base_diameter = preset_value(paper_thickness_preset, "cone_counter_dot_base_diameter", cone_counter_dot_base_diameter);
_preset_cone_counter_dot_height        = preset_value(paper_thickness_preset, "cone_counter_dot_height",        cone_counter_dot_height);
_preset_cone_counter_dot_flat_hat      = preset_value(paper_thickness_preset, "cone_counter_dot_flat_hat",      cone_counter_dot_flat_hat);

// Cylinder parameters
_preset_cylinder_diameter_mm           = preset_value(paper_thickness_preset, "cylinder_diameter_mm",           cylinder_diameter_mm);
_preset_cylinder_height_mm             = preset_value(paper_thickness_preset, "cylinder_height_mm",             cylinder_height_mm);
_preset_polygon_cutout_radius_mm       = preset_value(paper_thickness_preset, "polygon_cutout_radius_mm",       polygon_cutout_radius_mm);
_preset_polygon_cutout_points          = preset_value(paper_thickness_preset, "polygon_cutout_points",          polygon_cutout_points);
_preset_seam_offset_degrees            = preset_value(paper_thickness_preset, "seam_offset_degrees",            seam_offset_degrees);

// =============================================================================
// ACTIVE PARAMETERS - Final values used by geometry
// =============================================================================
// These variables provide the final parameter values used by the geometry code.
// They incorporate both preset routing (above) and shape-based routing (rounded vs cone).

// Active emboss dot parameters (based on shape selection, using preset-routed values)
// Note: cone/rounded emboss modules consume the underlying _preset_* constants
// directly; only the composite height is needed at this layer.
// Double-sided ships its own FIXED footprint (Option B):
// raised dots and recesses now share one surface, and at the single-sided sizes
// only 0.118 mm of material would be left between neighbours. So the ds gate
// wins over both the shape selection and the paper-thickness preset, and no
// dial reaches it. `braille_dot_for_plate` below routes the matching solid.
active_emboss_height = ds_on ? DS_DOT_HEIGHT :
                       use_rounded_dots ? (_preset_rounded_dot_base_height + _preset_rounded_dot_dome_height) : _preset_emboss_dot_height;

// Active counter dot parameters (based on shape selection, using preset-routed values)
active_counter_height = use_rounded_dots ? _preset_counter_dot_depth : _preset_cone_counter_dot_height;

// Active spacing parameters (pass through from preset routing)
active_grid_columns = _preset_grid_columns;
active_grid_rows = _preset_grid_rows;
active_cell_spacing = _preset_cell_spacing;
active_line_spacing = _preset_line_spacing;
active_dot_spacing = _preset_dot_spacing;
active_braille_y_adjust = _preset_braille_y_adjust;

// Active cylinder parameters (pass through from preset routing)
active_cylinder_diameter_mm = _preset_cylinder_diameter_mm;
active_cylinder_height_mm = _preset_cylinder_height_mm;
active_polygon_cutout_radius_mm = _preset_polygon_cutout_radius_mm;
active_polygon_cutout_points = _preset_polygon_cutout_points;
active_seam_offset_degrees = _preset_seam_offset_degrees;

// Both-plates mode, PRINT layout only: centres one diameter plus the gap
// apart puts the barrel surfaces exactly pair_spacing_mm apart. Not related
// to the 32.0473 mm meshed-gear assembly distance. Brennen chose the
// barrel-based measure on 2026-08-25 (gear tips overhang it; the slider
// comment carries that caveat).
pair_center_offset_mm = active_cylinder_diameter_mm + pair_spacing_mm;

// -----------------------------------------------------------------------------
// TACTILE INDICATOR CONSTANTS
// -----------------------------------------------------------------------------
// Declared here, ahead of the grid maths, because OpenSCAD evaluates top-level
// assignments strictly in source order — a constant used by a calculated value
// must already exist at that point. (Constants consumed only inside modules,
// like INDICATOR_OVERCUT below, can be declared later.)

// Clear zone required either side of the indicator, on top of its own width,
// before the seam gap is considered too tight (2 mm dot zone per neighbouring
// cell plus 1 mm of margin).
TACTILE_MIN_GAP_MARGIN = 5.0;

// The card a tactile row has to fit, measured from the alignment arrow where
// its leading edge sits (web decision D-T3, 2026-09-21): the 90 mm business
// card the web generator carries as card_width. A constant, not a dial - the
// web app reads its own field.
CARD_LENGTH_MM = 90;

// Tactile mode's seam channel runs down the arrow column itself (web decision
// D-T6, 2026-09-21), the full height (D-T7: Brennen's print showed the slicer
// choosing dots wherever the groove stopped), and on the emboss plate it steps
// round each raised arrow on the first-cell side instead of running through
// it (D-T8, 2026-09-22: the V through the arrow took its point and made the
// triangle less distinguishable by touch). It leaves the column at this slant
// from the axis, rounds the base corner, runs beside the long side and rounds
// the tip back to the column, its mouth SEAM_CHANNEL_MARGIN_MM clear of the
// arrow; the slant, not a run along the base, keeps a V on every printed
// layer. The round corners are chords of at most the arc step, set outside
// the circle, and a sideways stretch is split into pieces no longer than the
// step so each chord stays on the barrel. Mirrors the web generator's
// app/geometry_spec.py values one for one (tests/test_tactile_mode.py diffs
// them).
SEAM_CHANNEL_DETOUR_SLANT_DEG    = 45;    // slant off the axis on the way round an arrow, degrees
SEAM_CHANNEL_DETOUR_ARC_STEP_DEG = 7.5;   // largest arc a round corner's chord spans, degrees
SEAM_CHANNEL_DETOUR_STEP_MM      = 1.0;   // longest sideways piece of the path, mm

// Slicer seam channel: a V groove along the outer surface - the full height
// beside the row-indicator column in Visual mode, the full height down the
// arrow column and round the raised arrows in Tactile mode - so a slicer's
// default "aligned" seam mode hides each layer's seam in it instead of in a
// braille dot. Mirrors
// the web generator's app/geometry_spec.py SEAM_CHANNEL_* one for one
// (tests/test_seam_channel_scad.py diffs them); changing the groove needs
// Brennen's decision AND a new slicing spike (web decisions D-13..D-15).
SEAM_CHANNEL_WIDTH_MM     = 1.0;   // mouth width at the surface, mm
SEAM_CHANNEL_DEPTH_MM     = 0.5;   // apex depth below the surface, mm (90 degree V)
SEAM_CHANNEL_MARGIN_MM    = 0.25;  // clear surface kept on each side, mm
SEAM_CHANNEL_OVERSHOOT_MM = 1.0;   // cutter length past each end face, mm
SEAM_CHANNEL_LIP_MM       = 0.5;   // cutter sides carried past the surface, mm
SEAM_CHANNEL_MIN_WALL_MM  = 1.2;   // FDM minimum wall under the apex, mm

// Normalised gate for the `seam_channel` dropdown, read the way gears_on reads
// its own: "On"/"Off" from the Customizer, "on"/"off" from -D.
seam_channel_on = (seam_channel == "On") || (seam_channel == "on");

// Radial thickness of the working prism the arrow is extruded into. Must exceed
// raise + recess depth + base embed so the prism always straddles the shell
// surface; the shell band intersection is what sets the actual raise/depth.
TACTILE_PRISM_SPAN = 6;

// How far the raised arrow's base sinks below the shell surface, so the union
// with the shell is a solid overlap rather than a coplanar touch.
TACTILE_BASE_EMBED = 0.2;

// How far the recess cutter projects past the shell surface, so the cut opening
// never leaves coplanar faces behind.
TACTILE_RECESS_OVERCUT = 1;

// Arrow layout along the axis (Brennen, 2026-09-20). The "0.4mm" preset keeps
// one arrow per braille row; the "0.3mm" preset marks its cylinders with
// exactly three arrows, at mid-height and TACTILE_THREE_SPACED_PITCH above and
// below it, whatever the row count - so a blind user can tell the presets
// apart by touch (three separated arrows against a chain of four touching
// ones) and a 0.3mm cylinder will not nest with a 0.4mm one: the middle
// arrow's 4 mm base lands where the per-row recess chain is only 2.2 mm wide.
// "Custom" is an explicit choice here (no auto-detection, unlike the web UI),
// so it keeps one per row like the default. 15 mm was chosen over the
// quarter-height points: the same 40 mm span as the four-row chain, 5 mm gaps
// that are easy to count, one number for the 52 and 54 mm barrels alike.
// Keep in lockstep with the web repo's app/geometry_spec.py
// TACTILE_THREE_SPACED_PITCH_MM; tests/test_tactile_mode.py pins it.
tactile_three_spaced = (paper_thickness_preset == "0.3mm");
TACTILE_THREE_SPACED_PITCH = 15;

// The three fixed arrows must stay on the barrel. Measured on the larger,
// clearance-grown recess outline so both plates of a pair pass or fail
// together; a rejection, not a warning, to match the web generator (Brennen,
// 2026-09-20). Both presets set the cylinder to 52 mm, so the shipped defaults
// pass at every slider setting (the slider maxima need 45 mm).
assert(!(tactile_on && tactile_three_spaced)
       || active_cylinder_height_mm >= 2 * (TACTILE_THREE_SPACED_PITCH
                                            + tactile_indicator_length / 2
                                            + tactile_recess_clearance),
       "The 0.3mm preset's three tactile arrows need a taller cylinder: at least 2 x (15 + tactile_indicator_length / 2 + tactile_recess_clearance) mm.");

// Grid dimensions. In Visual indicator mode the triangle alignment marker column
// is ALWAYS present (it has no user-facing toggle) and the indicator letter/square
// column is added only when Indicator Letters are On. Tactile mode has no marker
// columns at all — its indicator lives in the seam gap — so the grid is exactly
// the text cells and the freed space widens the gap.
actual_grid_columns = tactile_on ? active_grid_columns :
                      indicator_on ? (active_grid_columns + 2) : (active_grid_columns + 1);
grid_width = (actual_grid_columns - 1) * active_cell_spacing;

// Seam gap: the arc between the last and first cell centers, measured the long
// way around through the seam. The grid is centered on angle 0, so the middle of
// this gap is always exactly 180° - where the tactile indicator sits, on both
// plates, with equal space either side of it (a fixed lead-in before the first
// cell was tried and reverted the same day, 2026-09-21, web decision D-T6).
// Warn when the gap can no longer hold the indicator plus a clear zone either
// side of it.
seam_gap_mm = PI * active_cylinder_diameter_mm - grid_width;
tactile_gap_too_small = tactile_on && (seam_gap_mm < tactile_indicator_width + TACTILE_MIN_GAP_MARGIN);

if (tactile_gap_too_small)
    echo(str("WARNING: Tactile indicator needs a seam gap of at least ",
             tactile_indicator_width + TACTILE_MIN_GAP_MARGIN, " mm; the current layout leaves ",
             seam_gap_mm, " mm. Lower grid_columns or raise cylinder_diameter_mm."));

// The braille text, in row order. This list is the single source of truth for
// the content: every capacity check, warning, and geometry loop reads it, never
// a Line_N name. Adding a row means declaring Line_N in the text input section
// above, appending it here, and raising the grid_rows slider max to match.
_all_lines = [Line_1, Line_2, Line_3, Line_4, Line_5,
              Line_6, Line_7, Line_8, Line_9, Line_10];

// Text-capacity check. Text capacity is always active_grid_columns; in Visual mode
// the grid is widened by 2 marker cells when Indicator Letters are On, or by 1 (the
// alignment triangle) when Off, and Tactile mode adds none, so text capacity is
// unchanged in every case. The check (and row clipping) can be bypassed with
// text_limit_check = "Off", which renders every pasted cell — rows may then crowd
// the seam.
//
// Double-sided: ds_back_placements() clips back columns to active_grid_columns
// and back rows to active_grid_rows exactly as the front walk does, so the back
// lines are measured by the same two checks and the WIDEST row on either face
// decides. With the gate Off the back lines are never read and both numbers are
// the front's, unchanged.
_front_max_line_len = max([for (l = _all_lines) len(l)]);
_back_max_line_len  = ds_on ? max([for (l = _all_back_lines) len(l)]) : 0;
max_line_len = max(_front_max_line_len, _back_max_line_len);
text_too_long = (text_limit_check == "On") && (max_line_len > active_grid_columns);

// Row-capacity check. Only the first active_grid_rows rows are ever rendered, so
// text pasted into a line past that limit vanishes with nothing to show for it.
// rows_used is the index of the last non-empty line + 1, which preserves blank
// rows deliberately left between filled ones. Unlike the cell-capacity check this
// is not gated on text_limit_check: extra rows cannot be rendered anyway, there is
// no "draw it regardless" option to opt into. The DEEPEST row on either face wins.
_filled_row_idx = [for (i = [0 : len(_all_lines) - 1]) if (len(_all_lines[i]) > 0) i];
_front_rows_used = len(_filled_row_idx) == 0 ? 0 : _filled_row_idx[len(_filled_row_idx) - 1] + 1;
_filled_back_row_idx = ds_on
    ? [for (i = [0 : len(_all_back_lines) - 1]) if (len(_all_back_lines[i]) > 0) i]
    : [];
_back_rows_used = len(_filled_back_row_idx) == 0
    ? 0
    : _filled_back_row_idx[len(_filled_back_row_idx) - 1] + 1;
rows_used = max(_front_rows_used, _back_rows_used);
too_many_rows = rows_used > active_grid_rows;

// Console diagnostics for desktop users (the MakerWorld customizer preview
// cannot show console output — it relies on the extruded 3D warning text). Each
// message names the field that actually overflowed, so a double-sided user is
// never sent hunting through the front text for a back-line problem.
if (text_limit_check == "On") {
    for (i = [0 : len(_all_lines) - 1])
        if (len(_all_lines[i]) > active_grid_columns)
            echo(str("WARNING: Line_", i + 1, " uses ", len(_all_lines[i]), " cells; capacity is ", active_grid_columns, ". Raise grid_columns, split across rows, or set text_limit_check = Off."));
    if (ds_on)
        for (i = [0 : len(_all_back_lines) - 1])
            if (len(_all_back_lines[i]) > active_grid_columns)
                echo(str("WARNING: Back_Line_", i + 1, " uses ", len(_all_back_lines[i]), " cells; capacity is ", active_grid_columns, ". Raise grid_columns, split across rows, or set text_limit_check = Off."));
}
if (too_many_rows) {
    if (_front_rows_used > active_grid_rows)
        echo(str("WARNING: text reaches Line_", _front_rows_used, " but grid_rows is ", active_grid_rows,
                 ", so Line_", active_grid_rows + 1, " onward will not be rendered. Raise grid_rows to ",
                 _front_rows_used, " (the cylinder needs roughly ", _front_rows_used * active_line_spacing,
                 " mm of height to hold that many rows)."));
    if (_back_rows_used > active_grid_rows)
        echo(str("WARNING: back text reaches Back_Line_", _back_rows_used, " but grid_rows is ", active_grid_rows,
                 ", so Back_Line_", active_grid_rows + 1, " onward will not be rendered. Raise grid_rows to ",
                 _back_rows_used, " (the cylinder needs roughly ", _back_rows_used * active_line_spacing,
                 " mm of height to hold that many rows)."));
}
grid_height = (active_grid_rows - 1) * active_line_spacing;
top_margin = (active_cylinder_height_mm - grid_height) / 2;

// Cylinder grid geometry — shared by cylinder_emboss_plate and
// cylinder_counter_plate. Both modules used to recompute these identically
// inline; hoisting them keeps the two plates in lockstep so any spacing
// change automatically applies to both. Names mirror the prior local names
// so the module bodies need no changes beyond removing the duplicates.
radius                = active_cylinder_diameter_mm / 2;
grid_angle            = grid_width / radius;
start_angle           = -grid_angle / 2;
cell_spacing_angle    = active_cell_spacing / radius;
dot_spacing_angle     = active_dot_spacing / radius;
dot_col_angle_offsets = [-dot_spacing_angle / 2, dot_spacing_angle / 2];
dot_row_offsets       = [active_dot_spacing, 0, -active_dot_spacing];
dot_positions         = [[0, 0], [1, 0], [2, 0], [0, 1], [1, 1], [2, 1]];

// Slicer seam channel placement - the web generator's _seam_channel_block(),
// ported verbatim. Positions are signed arcs `s` along the surface from the
// seam centre (180 degrees), positive TOWARD column 0; the free window
// [lo, hi] is what the features either side leave of the seam gap and the
// groove sits at its middle so both margins are equal. The footprint is the
// SAME number on both plates, so the two grooves mirror exactly.
//
// ANGLE CONVENTION. This file places dots at their physical angle
// (start_angle = -grid_angle / 2, so column 0 sits on the NEGATIVE side of
// the seam centre) and the counter plate negates angles. Toward column 0 from
// 180 is therefore INCREASING angle on the emboss plate and decreasing on the
// counter plate: 181.67 / 178.33 degrees for the default 15-column visual
// layout at 30.8 mm - the same physical angles the web generator's STL
// carries (its spec theta is in the dot convention that its worker negates).
// Never treat this angle differently from a dot's.
seam_channel_footprint_mm = active_dot_spacing / 2
    + (ds_on
        ? max(DS_DOT_BASE_DIA / 2, DS_BOWL_DIA / 2)
        : max(use_rounded_dots ? _preset_rounded_dot_base_diameter / 2 : _preset_emboss_dot_base_diameter / 2,
              use_rounded_dots ? _preset_bowl_counter_dot_base_diameter / 2 : _preset_cone_counter_dot_base_diameter / 2));
// Card fit (web decisions D-T3, D-T4, 2026-09-21): the embosser is loaded with
// the card's leading edge at the alignment arrow, which sits at the middle of
// the seam gap, so a tactile row needs half the gap plus the grid plus the last
// cell's footprint of card. 13 cells at the 0.4mm preset need 89.5 mm and fit
// a 90 mm card; 14 need 92.8 and lose their last cell at ANY arrow position -
// which is how this rule was found. A NOTE and a red badge, never a stop: the
// cylinder itself still holds the row. Mirrors the web generator's
// tactile_card_need_mm() / tactile_max_cells().
tactile_card_need_mm = seam_gap_mm / 2 + grid_width + seam_channel_footprint_mm;
tactile_card_too_long = tactile_on && (tactile_card_need_mm > CARD_LENGTH_MM);
tactile_card_max_cells = max(0,
    floor((CARD_LENGTH_MM - PI * active_cylinder_diameter_mm / 2 - seam_channel_footprint_mm) * 2
          / active_cell_spacing) + 1);
if (tactile_card_too_long) {
    echo(str("NOTE: this row needs ", round(tactile_card_need_mm * 10) / 10,
             " mm of card from the alignment arrow; the card is ", CARD_LENGTH_MM,
             " mm. Lower grid_columns to ", tactile_card_max_cells, " or fewer."));
}

// Rows fit (Brennen, 2026-10-09): the braille rows' dots must stay on the card
// and the per-row tactile arrows on the barrel, or the model stops with the
// same sentence the web generator refuses with (its app/validation.py
// validate_braille_rows_fit, measured by app/geometry_spec.py
// braille_rows_extent). Rows are centred on the height and moved by
// braille_y_adjust. The outer dots reach the dot spacing plus the widest dot or
// bowl radius past the outer row centre (seam_channel_footprint_mm's radius).
// The arrows are measured on the counter plate's recess, grown by
// tactile_recess_clearance (or the gear weld, if larger) with a sharp tip, which
// moves the tip delta * sqrt(1 + (2 * length / width)^2) - 6.02 mm above the row
// centre at the defaults. The card is the limit when it is the shorter of the
// two (the 52 mm card sits in the middle of Version 2's 54 mm barrel). At the
// defaults 5 Visual and 4 Tactile rows fit 52 mm. tests/test_rows_fit.py pins
// the rule and both sentences against the web repo.
CARD_HEIGHT_MM = 52;
function rows_fit_mm(x) = str(round(x * 1000) / 1000);
rows_fit_span = (active_grid_rows - 1) * active_line_spacing;
rows_fit_top_row = rows_fit_span / 2 + active_braille_y_adjust;
rows_fit_bottom_row = rows_fit_top_row - rows_fit_span;
rows_fit_dot_reach = seam_channel_footprint_mm + active_dot_spacing / 2;
rows_fit_dots_need = 2 * max(rows_fit_top_row + rows_fit_dot_reach, rows_fit_dot_reach - rows_fit_bottom_row);
rows_fit_card_limits = CARD_HEIGHT_MM < active_cylinder_height_mm;
rows_fit_arrow_delta = gears_on ? max(tactile_recess_clearance, GEAR_ARROW_WELD_MM) : tactile_recess_clearance;
rows_fit_arrows_need = (tactile_on && !tactile_three_spaced)
    ? 2 * max(rows_fit_top_row + tactile_indicator_length / 2
                  + rows_fit_arrow_delta * sqrt(1 + pow(2 * tactile_indicator_length / tactile_indicator_width, 2)),
              tactile_indicator_length / 2 + rows_fit_arrow_delta - rows_fit_bottom_row)
    : 0;
rows_fit_barrel_need = max(rows_fit_card_limits ? 0 : rows_fit_dots_need, rows_fit_arrows_need);
assert(!(rows_fit_card_limits && rows_fit_dots_need > CARD_HEIGHT_MM + 1e-9),
       str("These ", active_grid_rows, " rows need ", rows_fit_mm(rows_fit_dots_need), " mm of the card's ",
           rows_fit_mm(CARD_HEIGHT_MM), " mm height, so the top and bottom rows would run off the card. ",
           "Use fewer rows or a smaller line spacing."));
assert(rows_fit_barrel_need <= active_cylinder_height_mm + 1e-9,
       str("These ", active_grid_rows, " rows need ", rows_fit_mm(rows_fit_barrel_need), " mm of the cylinder's ",
           rows_fit_mm(active_cylinder_height_mm), " mm height, so the top and bottom rows would run off the ends. ",
           "Use fewer rows, a smaller line spacing, or a taller cylinder."));

// The groove's window, Visual mode: between the last cell's dots and column 0's
// triangle. Tactile mode has no window - the groove runs down the arrow column
// itself, the full height - but on the emboss plate it steps round the raised
// arrows on the first-cell side (D-T8; the path is computed below the omission
// notes), which needs half an arrow, the groove and a margin either side of it
// before the first cell's dots. Both plates keep or lose the groove together.
seam_channel_lo_mm = -(seam_gap_mm / 2 - seam_channel_footprint_mm);   // past the last cell's dots
seam_channel_hi_mm = seam_gap_mm / 2 - active_dot_spacing / 2;         // before column 0's triangle
seam_channel_free_mm = tactile_on ? seam_gap_mm / 2 - seam_channel_footprint_mm
                                  : seam_channel_hi_mm - seam_channel_lo_mm;
seam_channel_need_mm = (tactile_on ? tactile_indicator_width / 2 : 0)
                       + SEAM_CHANNEL_WIDTH_MM + 2 * SEAM_CHANNEL_MARGIN_MM;
seam_channel_fits = seam_channel_free_mm >= seam_channel_need_mm;
// The wall under the apex: only a polygonal cutout can thin it - this shell
// has no wall-thickness hollowing (a barrel with no cutout is solid) and gear
// mode forces the barrel solid. The cutout's vertices reach the circumradius.
seam_channel_bore_mm = (gears_on || active_polygon_cutout_radius_mm <= 0)
    ? 0
    : active_polygon_cutout_radius_mm / cos(180 / active_polygon_cutout_points);
seam_channel_wall_mm = radius - SEAM_CHANNEL_DEPTH_MM - seam_channel_bore_mm;
seam_channel_wall_ok = (seam_channel_bore_mm <= 0) || (seam_channel_wall_mm >= SEAM_CHANNEL_MIN_WALL_MM);
seam_channel_present = seam_channel_on && seam_channel_fits && seam_channel_wall_ok;
// Tactile: 180 on BOTH plates, the arrow column (D-T6).
seam_channel_s_mm = tactile_on ? 0 : (seam_channel_lo_mm + seam_channel_hi_mm) / 2;
seam_channel_theta_emboss_deg  = 180 + (seam_channel_s_mm / radius) * 180 / PI;
seam_channel_theta_counter_deg = 180 - (seam_channel_s_mm / radius) * 180 / PI;

// The console copies of the omission sentences, S-C2, S-C3 and S-C5 - the web
// generator's own words, quoted verbatim and pinned by the tests; keep them
// identical. S-C5 is Tactile mode's: it names the room
// beside the arrows, because the arrow width can take it as well as the cell
// count and diameter. "NOTE:", never "WARNING:" - scripts\scad-check.ps1 fails
// on that token.
if (seam_channel_on && !seam_channel_fits && !tactile_on)
    echo("NOTE: The seam channel was left out: the seam gap is too narrow for it at this cell count and diameter.");
if (seam_channel_on && !seam_channel_fits && tactile_on)
    echo("NOTE: The seam channel was left out: there is not enough room for it beside the alignment arrows. Reduce the number of braille cells, increase the cylinder diameter, or narrow the indicator.");
if (seam_channel_on && seam_channel_fits && !seam_channel_wall_ok)
    echo(str("NOTE: The seam channel was left out: the cylinder wall would be thinner than ",
             SEAM_CHANNEL_MIN_WALL_MM, " mm under it."));

// Tactile mode, the emboss plate: the groove's centre line round the raised
// arrows (D-T8), the web generator's _tactile_detour_path() ported line for
// line. Points are [z, x] in the arrows' tangent plane at 180 degrees - z
// about mid-height, x across the column, NEGATIVE toward the first braille
// cell - where the raised outline is exactly tactile_raised()'s triangle,
// grown by the gear-mode weld as a mitre. Round one arrow the line keeps
// SEAM_CHANNEL_WIDTH_MM / 2 + SEAM_CHANNEL_MARGIN_MM from the outline and slants
// at most SEAM_CHANNEL_DETOUR_SLANT_DEG off the axis; with several arrows it is
// the lower envelope of the one-arrow lines, so the per-row arrows, which touch
// tip to base, get a zig-zag from each side out to the next arrow's corner. A
// point's physical angle is 180 - asin(x / radius): above 180, the first-cell
// side, as the Visual groove's 181.67 is. The counter plate's recesses are
// deeper than the groove, so its straight cut already runs through them.

// Round the circle of radius r about (cx, cz) from angle a0 to a1: both ends on
// the circle and a vertex per arc step between them, pushed out so each chord
// touches the circle instead of cutting inside it.
function seam_detour_arc(cx, cz, r, a0, a1) =
    abs(a1 - a0) < 1e-9 ? [[cz + r * sin(a0), cx + r * cos(a0)]]
    : let (n = ceil(abs(a1 - a0) / SEAM_CHANNEL_DETOUR_ARC_STEP_DEG),
           step = (a1 - a0) / n,
           outer = r / cos(step / 2))
      concat([[cz + r * sin(a0), cx + r * cos(a0)]],
             [for (k = [0 : n - 1]) let (a = a0 + step * (k + 0.5)) [cz + outer * sin(a), cx + outer * cos(a)]],
             [[cz + r * sin(a1), cx + r * cos(a1)]]);

// One arrow's line, x <= 0 and 0 at both ends: a slant in to the circle of
// radius d about the base corner, round it, parallel to the long side, round
// the tip and a slant back. A short, wide arrow whose side is flatter than the
// slant is left straight from its base corner: its tip is already clear.
function seam_detour_one(base, tip, half_base, d, slant) =
    let (side = atan2(half_base, tip - base))
    concat([[base - (d + half_base * cos(slant)) / sin(slant), 0]],
           side <= slant
               ? concat(seam_detour_arc(-half_base, base, d, 180 + slant, 180 - side),
                        seam_detour_arc(0, tip, d, 180 - side, 180 - slant),
                        [[tip + d / sin(slant), 0]])
               : concat(seam_detour_arc(-half_base, base, d, 180 + slant, 180 - slant),
                        [[base + (d + half_base * cos(slant)) / sin(slant), 0]]));

// A line's x at height z, 0 outside its span.
function seam_detour_x_at(line, z) =
    let (hits = [for (i = [0 : len(line) - 2])
                     if (line[i][0] <= z && z <= line[i + 1][0])
                         line[i][1] + (line[i + 1][1] - line[i][1]) * (z - line[i][0]) / (line[i + 1][0] - line[i][0])])
    len(hits) > 0 ? hits[0] : 0;

// Ascending, duplicates dropped.
function seam_detour_sort(v) =
    len(v) <= 1 ? v
    : let (pivot = v[floor(len(v) / 2)])
      concat(seam_detour_sort([for (x = v) if (x < pivot) x]), [pivot],
             seam_detour_sort([for (x = v) if (x > pivot) x]));
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
