BrennenJohnston/braille-cylinder-stl-generator-openscad/(list of files, cad)

Other CAD files:
assets/gears_b.stl
tests/fixtures/cross_platform/cylinder_cone_counter_indicators_off/reference.stl
tests/fixtures/cross_platform/cylinder_cone_counter_indicators_on/reference.stl
tests/fixtures/cross_platform/cylinder_cone_emboss_indicators_off/reference.stl
tests/fixtures/cross_platform/cylinder_cone_emboss_indicators_on/reference.stl
tests/fixtures/cross_platform/cylinder_indicator_recess_cone/reference.stl
tests/fixtures/cross_platform/cylinder_indicator_recess_rounded/reference.stl
tests/fixtures/cross_platform/cylinder_rounded_counter_03mm/reference.stl
tests/fixtures/cross_platform/cylinder_rounded_counter_indicators_off/reference.stl
tests/fixtures/cross_platform/cylinder_rounded_counter_indicators_on/reference.stl
tests/fixtures/cross_platform/cylinder_rounded_counter_tactile/reference.stl
tests/fixtures/cross_platform/cylinder_rounded_emboss_03mm/reference.stl
tests/fixtures/cross_platform/cylinder_rounded_emboss_custom_cutout/reference.stl
tests/fixtures/cross_platform/cylinder_rounded_emboss_indicators_off/reference.stl
tests/fixtures/cross_platform/cylinder_rounded_emboss_indicators_on/reference.stl
tests/fixtures/cross_platform/cylinder_rounded_emboss_multiline/reference.stl
tests/fixtures/cross_platform/cylinder_rounded_emboss_tactile/reference.stl
assets/gears_a.stl
assets/v2_gears_b.stl
assets/v2_gears_a.stl
Braille_Cylinder_STL_Generator_EmbosserV2.scad
makerworld/Braille_Cylinder_STL_Generator_MakerWorld_v2.scad
makerworld/Braille_Cylinder_STL_Generator_MakerWorld.scad
makerworld/Braille_Cylinder_STL_Generator_MakerWorld_v1.5.scad
