BrennenJohnston/braille-cylinder-stl-generator-openscad/tests/fixtures/cross_platform/README_FIXTURE_GENERATION.md

# Reference Fixture Generation Guide

This document explains how to generate reference STL fixtures for cross-platform validation.

## Overview

Reference fixtures are "golden" STL files generated by the **web generator** (JavaScript implementation) that serve as the source of truth for validating the **OpenSCAD generator** (this repository).

**Important**: Fixtures must be generated from the web generator, NOT from OpenSCAD. OpenSCAD-generated fixtures only validate internal consistency, not cross-platform parity.

## Current Status (2026-01-09)

- **Web API**: Deprecated (410 Gone as of 2026-01-05) - server-side STL generation removed
- **Current fixtures**: OpenSCAD self-test mode (NOT true cross-platform validation)
- **Required action**: Generate new fixtures from web generator using one of the methods below

## Fixture Generation Methods

### Method 1: Web UI Automation (Playwright) - RECOMMENDED FALLBACK

Use Playwright to automate the deployed web UI and download STLs.

**Setup (one-time):**

```bash
# Install Playwright
pip install playwright

# Install Chromium browser
python -m playwright install chromium
```

**Generate fixtures:**

```bash
# Generate all fixtures
python scripts/generate_web_fixtures.py --web-url https://your-web-generator-url.com

# Generate specific fixture
python scripts/generate_web_fixtures.py --web-url https://your-web-generator-url.com --test-case cylinder_rounded_emboss_indicators_on

# Dry run (check setup)
python scripts/generate_web_fixtures.py --web-url https://your-web-generator-url.com --dry-run

# Debug mode (visible browser)
python scripts/generate_web_fixtures.py --web-url https://your-web-generator-url.com --no-headless
```

**Important Notes:**

- Web UI selectors in `scripts/generate_web_fixtures.py` are **PLACEHOLDERS**
- You MUST update selectors to match the actual web UI structure
- Test with `--no-headless` first to verify automation works
- Record the web generator commit/version used (add to fixture metadata)

### Method 2: Headless Web Generator (Source Code) - PREFERRED (Not Yet Implemented)

Run the web generator source code headlessly using Node.js to generate STLs programmatically.

**Requirements:**

1. Clone web generator repository: `github.com/BrennenJohnston/braille-cylinder-stl-generator`
2. Identify STL generation entry point (client-side generator module)
3. Create Node.js script to:
   - Accept parameters from `test_cases.json`
   - Generate STL byte buffer (same as web UI download)
   - Write to fixture directory

**Advantages:**

- Deterministic (no UI automation flakiness)
- Faster (no browser overhead)
- Exact commit hash tracking
- No selector maintenance

**Status**: Not yet implemented. Requires investigation of web generator source structure.

### Method 3: OpenSCAD Self-Test (DEPRECATED for Cross-Platform Validation)

**DO NOT USE** for cross-platform validation. Only validates OpenSCAD internal consistency.

```bash
# This generates OpenSCAD fixtures (NOT web reference fixtures)
python scripts/regenerate_fixtures.py --openscad-mode
```

Use this ONLY for:
- Quick local testing during OpenSCAD development
- Verifying OpenSCAD installation works
- Debugging OpenSCAD parameter handling

## Test Case Matrix

Current test suite (16 cylinder tests):

### Core Matrix (8 tests)
All combinations of: dot shape (rounded/cone) × plate type (emboss/counter) × indicators (on/off)

1. `cylinder_rounded_emboss_indicators_on`
2. `cylinder_rounded_emboss_indicators_off`
3. `cylinder_rounded_counter_indicators_on`
4. `cylinder_rounded_counter_indicators_off`
5. `cylinder_cone_emboss_indicators_on`
6. `cylinder_cone_emboss_indicators_off`
7. `cylinder_cone_counter_indicators_on`
8. `cylinder_cone_counter_indicators_off`

### Indicator Isolation (2 tests)
Minimal fixtures for indicator recess bug diagnosis:

9. `cylinder_indicator_recess_rounded` (1 row, no text, indicators only)
10. `cylinder_indicator_recess_cone` (1 row, no text, indicators only)

### Parametric Variation (1 test)

11. `cylinder_rounded_emboss_custom_cutout` (hexagonal cutout, custom seam)

### Preset / Multiline Coverage (3 tests)

12. `cylinder_rounded_emboss_multiline` (multi-line render path)
13. `cylinder_rounded_emboss_03mm` (0.3mm paper-thickness preset, emboss)
14. `cylinder_rounded_counter_03mm` (0.3mm paper-thickness preset, counter)

### Indicator Mode (2 tests)
Tactile indicator mode — raised seam-gap arrow instead of marker columns:

15. `cylinder_rounded_emboss_tactile` (raised arrow at 180°)
16. `cylinder_rounded_counter_tactile` (matching arrow recess)

## Fixture Directory Structure

```
tests/fixtures/cross_platform/
├── test_cases.json                          # Test case definitions
├── FIXTURES_VERSION.json                    # Fixture metadata
├── FIXTURES_VERSION.txt                     # Human-readable version info
├── README_FIXTURE_GENERATION.md             # This file
├── cylinder_rounded_emboss_indicators_on/
│   ├── reference.stl                        # Web-generated reference STL
│   ├── params.json                          # Test parameters
│   └── metadata.json                        # Fixture metadata (checksums, properties)
├── cylinder_rounded_emboss_indicators_off/
│   └── ...
└── ...
```

## Fixture Metadata Requirements

Each fixture must record:

1. **Web generator version**: Commit hash or release tag
2. **Generation method**: `web_ui_playwright` or `web_source_headless`
3. **Generation timestamp**: ISO 8601 format
4. **STL checksum**: SHA-256 hash
5. **Mesh properties**: Volume, area, bbox, face/vertex counts, watertightness
6. **Test parameters**: Full parameter set from `test_cases.json`

## Fixture Versioning

When regenerating fixtures:

1. **Record web generator commit**: Add to `FIXTURES_VERSION.json`
2. **Update fixture version**: Increment version in `test_cases.json`
3. **Document changes**: Update `FIXTURES_VERSION.txt` with reason for regeneration
4. **Commit to Git LFS**: Fixtures are tracked with Git LFS (`.stl` files)

## Tessellation Settings

Fixtures use normalized tessellation settings per the plan:

- **Emboss plates**: `hemisphere_quality="medium"`, `cone_segments=16`
- **Counter plates**: `hemisphere_quality="low"`, `cone_segments=8` (faster rendering)

These settings are recorded in `test_cases.json` and fixture metadata.

## OpenSCAD Version Pinning

Fixtures require:

- **OpenSCAD version**: 2026.01.03 nightly
- **Backend**: Manifold (required for consistent geometry)
- **Render mode**: 3D render (default)

Recorded in `tests/tool_versions.yml` and enforced in CI.

## Comparison Profiles

Two tolerance profiles available:

1. **Baseline** (`tests/compare_config.json`):
   - Volume: ±1%, Area: ±0.5%, Bbox: ±0.1mm
   - Use for initial debugging and development

2. **Strict** (`tests/compare_config_strict.json`):
   - Volume: ±0.1%, Area: ±0.1%, Bbox: ±0.01mm
   - Use for final validation and CI quality gates

## Workflow Summary

1. **Setup**: Install Playwright and browsers
2. **Update selectors**: Modify `scripts/generate_web_fixtures.py` to match web UI
3. **Generate fixtures**: Run script against deployed web generator
4. **Verify fixtures**: Check STL files are valid and watertight
5. **Record metadata**: Ensure web commit hash is recorded
6. **Commit to Git LFS**: Add fixtures to version control
7. **Run tests**: Validate OpenSCAD output against web fixtures

## Troubleshooting

### Playwright automation fails

- Run with `--no-headless` to see browser
- Check web UI selectors in `scripts/generate_web_fixtures.py`
- Verify web generator URL is accessible
- Check browser console for errors

### Downloaded STL is empty or invalid

- Verify web generator is working (manual test)
- Check download timeout (increase if needed)
- Ensure web generator supports cylinder shape (card disabled)

### Fixtures don't match OpenSCAD output

- Expected! That's what we're testing for
- Use baseline config first to identify gross issues
- Tighten to strict config after initial fixes
- Document geometry discrepancies in plan

## Future Improvements

1. **Implement headless web generator**: Run web source code directly (preferred)
2. **Automate selector extraction**: Scrape web UI to auto-detect selectors
3. **CI integration**: Auto-regenerate fixtures on web generator updates
4. **Visual diff tooling**: Generate side-by-side comparison images
5. **Geometry isolation tests**: Add single-dot fixtures for each geometry type

## References

- Test cases: `tests/fixtures/cross_platform/test_cases.json`
- Tool versions: `tests/tool_versions.yml`
- Comparison config: `tests/compare_config.json`, `tests/compare_config_strict.json`
