BrennenJohnston/braille-cylinder-stl-generator-openscad/tests/fixtures/cross_platform/FIXTURES_VERSION.txt

# Reference Fixture Version Information
# Generated: 2026-07-27T03:17:52.716633Z
# Method: OpenSCAD self-test mode
# OpenSCAD: OpenSCAD version 2026.01.03
# Total fixtures: 16
# Failed: 0

# See FIXTURES_VERSION.json for full metadata
