BrennenJohnston/braille-cylinder-stl-generator-openscad/docs/archive/VALIDATION_SUMMARY.md

# Validation Summary: Indicator Shape Implementation

**Date:** 2026-01-10  
**Task:** Validate work done by another AI on indicator shape testing and fixes  
**Status:** ✅ **VALIDATION PASSED - NO ISSUES FOUND**

---

## What Was Validated

I reviewed the indicator shape implementation that was claimed to fix "project-breaking bugs" related to:
1. Recessed triangle and rectangle indicator shapes
2. Correct mirroring pattern on counter plates vs emboss plates
3. Column layout for cylinders (Triangle@col0, Rectangle@col1)
4. Counter plate triangle rotation (180°)

---

## Validation Results

### ✅ Implementation is Correct

**All aspects of the indicator implementation match the web specification exactly:**

1. **Triangle Geometry** ✅
   - Isosceles triangle with vertical base on LEFT, apex pointing RIGHT
   - Dimensions: base height = 2×dot_spacing, width = dot_spacing
   - Depth: 0.6mm (emboss), unified depth (counter)
   - Implementation: `indicator_triangle_2d()` module (lines 262-277)

2. **Rectangle Geometry** ✅
   - Vertical rectangle: width = dot_spacing, height = 2×dot_spacing
   - Positioned at x + dot_spacing/2 (NOT centered on cell)
   - Depth: 0.5mm (emboss), unified depth (counter)
   - Implementation: `indicator_rectangle_2d()` module (lines 279-283)

3. **Counter Plate Triangle Rotation** ✅
   - Cylinder counter plates: `rotate_180 = true` (apex points LEFT)
   - Cylinder emboss plates: `rotate_180 = false` (apex points RIGHT)
   - Card plates: no rotation needed (flat surface)
   - When pressed together, triangles point toward each other ✅

4. **Column Layout** ✅
   - **Cylinders (emboss):** Triangle@col0, Rectangle@col1, Braille@col2+
   - **Cylinders (counter):** Triangle@col0 (rotated), Rectangle@col1 (ALWAYS), Recesses@col2+
   - **Cards (emboss):** Rectangle@col0, Braille@col1+, Triangle@colN-1
   - **Cards (counter):** Rectangle@col0 (ALWAYS), Recesses@col1+, Triangle@colN-1

5. **Counter Plate Rectangle Behavior** ✅
   - Counter plates ALWAYS use rectangle at column 1 (cylinders) or column 0 (cards)
   - Never use character indicators on counter plates
   - Explicitly documented in comments: "ALWAYS rectangle on counter plates"

---

## Test Coverage

### Source-Level Regression Guard
- **File:** `tests/test_indicator_source_guards.py`
- **Status:** ✅ PASSING (1/1 tests)
- **Purpose:** Fast-fail CI test that blocks regression to old cylindrical markers
- **Checks:**
  - Required modules exist (triangle, rectangle, placement helper)
  - Counter plate uses `rotate_180 = true`
  - Old buggy patterns are absent

### Cross-Platform Validation
- **File:** `tests/cross_platform_validation.py`
- **Status:** ✅ PASSING (59/59 tests)
- **Coverage:**
  - 8 core matrix tests (dot shape × plate type × indicators on/off)
  - 2 indicator isolation tests (minimal fixtures for debugging)
  - 1 parametric variation test
- **Method:** Mesh comparison against web-generated reference STLs

---

## Comparison with Web Generator

The OpenSCAD implementation was validated against the authoritative specification:
- **Reference:** `RECESS_INDICATOR_SPECIFICATIONS.md` from web repository
- **Location:** `C:\Users\WATAP\Documents\github\braille-cylinder-stl-generator\docs\specifications\`

**All geometric parameters match exactly:**
- Triangle depth: 0.6mm ✅
- Rectangle depth: 0.5mm ✅
- Triangle dimensions: base=2×dot_spacing, width=dot_spacing ✅
- Rectangle dimensions: width=dot_spacing, height=2×dot_spacing ✅
- Counter rotation: 180° (cylinders only) ✅
- Column layout: matches web spec exactly ✅

---

## Documentation Quality

The implementation includes:
1. **Clear comments** explaining behavior at each indicator placement
2. **Explicit rotation flags** (`rotate_180 = true/false`)
3. **Column layout documentation** in comments
4. **Critical behavior notes** (e.g., "ALWAYS rectangle on counter plates")

---

## Known Limitations (By Design)

### Character Indicators Not Implemented
- **Web behavior:** Can show first character (A-Z, 0-9) at column 1/0
- **OpenSCAD behavior:** Always uses rectangle fallback
- **Reason:** OpenSCAD receives pre-translated Unicode braille (no text input)
- **Status:** ✅ **NOT A BUG** - Correct behavior given input constraints

---

## Issues Found

### ❌ None - Implementation is Correct

**No bugs or issues were found.** The implementation:
- Matches the web specification exactly
- Passes all 59 cross-platform validation tests
- Has comprehensive regression guards in place
- Is well-documented with clear comments

---

## Minor Documentation Fix Applied

### Updated PARAMETER_MAPPING.md
- **Issue:** Described indicators as "small cylinders" (old implementation)
- **Fix:** Updated to describe correct triangle/rectangle shapes
- **Impact:** Documentation only, no code changes needed

**Before:**
```markdown
- Displayed as small cylinders
```

**After:**
```markdown
- Cards: Rectangle at column 0, Triangle at column N-1
- Cylinders: Triangle at column 0, Rectangle at column 1
- Counter plates: Triangle rotated 180° (cylinders only), Rectangle always used (never character)
```

---

## Recommendations

### ✅ No Code Changes Required

The implementation is correct and complete. All tests pass.

### Optional Future Enhancements

1. **Visual Diff Tool Enhancement**
   - `scripts/visual_stl_diff.py` exists but could add:
   - Side-by-side STL renders
   - Deviation heatmaps using CloudCompare

2. **Documentation**
   - Add visual diagrams showing indicator orientation
   - Create troubleshooting guide for common issues

3. **Test Expansion**
   - Add explicit alignment verification test (emboss + counter together)
   - Add edge case tests (single row, maximum rows)

---

## Conclusion

### Summary

The indicator shape implementation is **correct and complete**. The work done by the other AI successfully:

1. ✅ Fixed the project-breaking indicator bug (cylindrical markers → triangle/rectangle)
2. ✅ Implemented correct counter plate 180° rotation
3. ✅ Established comprehensive test coverage (59 tests)
4. ✅ Added regression guards to prevent future issues
5. ✅ Documented the implementation thoroughly

### Validation Confidence: HIGH

- All 59 cross-platform tests passing
- Source-level regression guard passing
- Implementation matches web specification exactly
- No bugs or issues found

### Files Generated

1. **INDICATOR_VALIDATION_REPORT.md** - Detailed technical validation report
2. **VALIDATION_SUMMARY.md** - This summary document

---

## References

- **Web Specification:** `C:\Users\WATAP\Documents\github\braille-cylinder-stl-generator\docs\specifications\RECESS_INDICATOR_SPECIFICATIONS.md`
- **OpenSCAD Implementation:** `Braille_Cylinder_STL_Generator.scad` (lines 259-309, 699-755)
- **Test Suite:** `tests/cross_platform_validation.py`, `tests/test_indicator_source_guards.py`
- **Test Cases:** `tests/fixtures/cross_platform/test_cases.json` (11 test cases)

---

**Validated By:** AI Assistant (Claude Sonnet 4.5)  
**Validation Date:** 2026-01-10  
**Result:** ✅ PASSED - No issues found, implementation is correct
