BrennenJohnston/braille-cylinder-stl-generator-openscad/(commit log)

2026-06-05 docs(experimental): seed braille-business-card research notes
    Adds the two research notes that motivate the Path 2 wedge prototype:
    print-stability/path recommendation and dot-geometry/slicer-quality.
    Branch-only; not merged to main.
2026-07-06 chore(card): baseline snapshot of wedge card generator before public-release refactor
    Pre-refactor state of the experimental leaning braille card generator (emboss/counter plates, indicators, 4 lines) plus the customizer usability research notes. Local feature-branch snapshot only; the presets JSON still contains personal preset sets that are replaced by curated, scrubbed presets before anything is published.
    [Braille_Wedge_Card_STL_Generator.scad]
2026-07-06 chore: gitignore local research material (New Research/, video transcripts)
    Keeps the third-party braillegen distribution, the ACM paper PDF, and the YouTube video transcripts out of the public repo. The example leaning-card reference models in the research folder stay untracked and optional.
2026-07-06 refactor(card)!: de-emboss into a pure directly-readable braille card
    Removes all embossing-era concepts from the wedge card generator: plate_type / Counter Plate path, counter recess modules and parameters, row indicators, the _preset_* routing shims, and the parent test-system compatibility shims (combined_shape, indicator_shapes, hemisphere_quality). card_emboss_plate() becomes union-only braille_card() (nothing is subtracted anymore); emboss_dot_* params renamed to cone_dot_*; active_emboss_height renamed to dot_total_height. Header rewritten around the single-card mission with a license line and VERSION 1.0.0. Verified: default render is manifold/NoError.
    [Braille_Wedge_Card_STL_Generator.scad]
2026-07-06 feat(card): 20 text rows, wider size ranges, bed warning, robust fins/bridges
    Line_5..Line_20 added with _all_lines as the single source of truth for every loop, warning, and layout module (with a documented recipe for extending past 20). grid_rows slider now 1-20, manual face size up to 300x250 mm, and a console warning fires when the effective face exceeds 250 mm (common print-bed limit). Watertightness fixes found while stress-testing: dots are embedded 0.02 mm into the face (exact coplanar seating exported dots as hundreds of floating shells), the fin brim stops short of the card's bottom-back corner, and bridges keep 0.1 mm clearance below the fin top plane -- plus the planned clamp so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
    [Braille_Wedge_Card_STL_Generator.scad]
2026-07-06 feat(card): Try_4 first-run defaults + curated scrubbed presets
    Defaults now match the print-tested Try_4 preset with warnings kept On: fins 25 mm/1.0 offset/1.2 thick, bridges 6x 0.5/0.5 at 0.3 contact, brim 2/0.2, card 1.5 mm thick, cell spacing 7.0, grid 11x5, rounded dot 1.6/0.35 + 1.4/0.35 (0.7 mm total, ADA-legal), render High with 40 cone segments. Presets JSON rewritten as three curated sets (Default Card, Compact Card (manual 75x25) from the FinsT2 fin/bridge values, Large 20-Line Card) using the new cone_dot_* names, no emboss/counter/indicator keys, and generic sample braille only -- the personal sets live on in an untracked *.local.json. Also fuses the rounded dot's dome to its b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
    [Braille_Wedge_Card_STL_Generator.scad]
2026-07-06 feat(card): self-contained project folder (docs, tests, CI, license)
    Restructures experimental/braille-business-card/ into a standalone repo-in-waiting: README (quick start, Customizer walkthrough, print guidance, preset loading, troubleshooting, MakerWorld upload steps incl. the license-choice flag, research credits), CHANGELOG v1.0.0, PolyForm NC LICENSE copy, .gitignore (*.local.json for personal presets), .gitattributes, pytest.ini, research notes moved to docs/. New lean test suite with no parent imports: test_customizer (dropdown hygiene + preset key/scrub checks), test_source_guards (20-line wiring, %-wrapped warnings, mission guard against embossing-era tokens), test_render_smoke (4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
    [Braille_Wedge_Card_STL_Generator.scad]
2026-07-06 fix(card-tests): add scipy to test requirements
    trimesh delegates its connected-component body_count check to scipy.sparse.csgraph; without scipy the render smoke tests fail on a clean CI runner (the local venv had scipy installed, masking the missing pin).
2026-07-06 chore: split wedge card generator to braille-wedge-card-openscad repo
    Deletes experimental/braille-business-card/ now that the project lives at https://github.com/BrennenJohnston/braille-wedge-card-openscad (extracted with history via git subtree split; CI green there). Adds a Spin-off Projects row in README.md and a CHANGELOG note under Unreleased. Cylinder code, tests, and fixtures untouched.
    [Braille_Wedge_Card_STL_Generator.scad]
2026-07-23 feat: raise capacity to 13 cells, add counted TEXT TOO LONG warning with bypass, add quick start guide
    grid_columns default 11 -> 13 to match the web app; grid_columns/grid_rows removed from paper-thickness presets (21 params). TEXT TOO LONG warning now shows longest-line/capacity counts plus per-line echo() diagnostics, and a new text_limit_check On/Off parameter bypasses clipping. Adds docs/MAKERWORLD_QUICK_START.md with an fpdf2-generated PDF and updates README, PARAMETER_MAPPING, makerworld README, and tests.
    [Braille_Cylinder_STL_Generator.scad, Braille_Cylinder_STL_Generator_MakerWorld.scad, presets.scad]
2026-07-23 feat: default dot shape Rounded; Indicator Letters toggle gates square only (triangle always on); regenerate fixtures
    [Braille_Cylinder_STL_Generator.scad, Braille_Cylinder_STL_Generator_MakerWorld.scad, reference.stl]
2026-07-27 feat: add Tactile indicator mode for unaided plate alignment
    Blind users could not align the emboss and counter cylinders without
    sighted help: the only alignment features were a recessed triangle and
    square that read as braille-like dots and gave no sense of which end was
    up. The new indicator_mode = Tactile drops those marker cells and puts a
    raised arrow on the emboss plate with a matching recess on the counter
    plate, one per row, centred in the seam gap.
    The gap midpoint is always exactly 180deg, which is the fixed point of the
    counter plate's mirror/angle-negation construction, so the pair
    self-aligns radially at any rotation. The arrow points at the cylinder
    top so either plate tells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
    [Braille_Cylinder_STL_Generator.scad, Braille_Cylinder_STL_Generator_MakerWorld_v2.scad, reference.stl]
2026-07-27 chore: rename repo to braille-cylinder-stl-generator-openscad
    Matches the web app companion's rename to braille-cylinder-stl-generator.
    Neither tool has generated flat cards since the web app's v2.0.0, so both
    old names advertised a feature that no longer exists. GitHub redirects the
    old URLs.
    Updated the CI badge (it embeds the repo name), clone/upstream commands,
    the LICENSE required notice, and every cross-link in the READMEs, docs,
    tests, and both SCAD headers. The Reference comment inside the geometry
    body is changed identically in both SCAD builds so the byte-identity that
    test_makerworld_sync.py enforces still holds.
    Also fixes the README's Spin-off Projects table, which linked the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
    [Braille_Cylinder_STL_Generator.scad, Braille_Cylinder_STL_Generator_MakerWorld_v2.scad]
2026-07-27 docs: cross-link the Custom Braille Embosser device and the sign/charm spin-offs
2026-07-27 ci: pin ruff, declare the rule set, and fix the findings it was hiding
    CI installed ruff unpinned, so the lint verdict depended on which version
    pip resolved that day — and with pip caching enabled, on cache state too.
    Ruff 0.16 turned UP/PIE/BLE/PLW/RUF on by default, which failed the sibling
    braille repos on unchanged trees while this repo's last run passed only
    because it restored an older cached wheel. Same code, different answer.
    Adds ruff.toml selecting E + F + I with E501 ignored, which is what the
    suite was written against, and pins ruff==0.16.0 so both the version and
    the rules live in the repo instead of in a runner's cache.
    Under that selection ruff found 37 real issues this r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
2026-07-27 docs: point embosser references at the model pages, not the private repo
    The custom-braille-embosser-3d-printing-project repo is private, so linking it 404'd for every visitor - the same problem the plug-puller link had. The device is still described in full; build files, print profiles, and documentation are reachable via its Printables, MakerWorld, and Thingiverse pages instead.
2026-07-30 docs: release 2.4.1 - point web app links at the new Vercel deployment
    [Braille_Cylinder_STL_Generator.scad, Braille_Cylinder_STL_Generator_MakerWorld_v2.scad]
2026-08-02 feat: add Line_5-Line_10 and a counted TOO MANY LINES warning
    grid_rows has allowed up to 10 rows since 2.0.0, but only four Line_N
    fields existed, so rows 5 through 10 were reachable only by editing the
    source or passing -D flags. Line_5-Line_8 join the main text tab;
    Line_9 and Line_10 go in a new [More Braille Lines (Advanced)] tab,
    since the Customizer cannot add fields on demand and putting all ten in
    the first tab pushes the other settings off screen for the common case.
    Parameter names are unchanged, so presets and -D overrides still work.
    Braille pasted past grid_rows used to vanish from the exported STL with
    no console message and nothing on the model. It now reports
    TOO MANY LINES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
    [Braille_Cylinder_STL_Generator.scad, Braille_Cylinder_STL_Generator_MakerWorld_v2.scad]
2026-08-19 fix(defaults): align the tactile indicator defaults with the web app
    Phase 08 parity audit. Of the 46 Customizer parameters, exactly two
    numeric defaults had drifted from the web generator, both tactile:
    tactile_indicator_length 5.0 -> 10.0 mm
    tactile_indicator_raise 0.8 -> 0.5 mm
    Every other parameter either agreed outright or is one of the documented
    web Layer 1 (schema) / Layer 2 (live UI) splits, where this file already
    tracks the live UI. Brennen approved both alignments 2026-08-18 after
    seeing before/after renders.
    Behaviour change for existing users in Tactile indicator mode only;
    Visual mode, the default, renders byte-identical. At the 10 mm default
    line_spacing the 10 mm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
    [Braille_Cylinder_STL_Generator.scad]
2026-08-19 feat(double-sided): port the interpoint clearance math into the .scad
    Adds a DOUBLE-SIDED (INTERPOINT) MATH section: the D1/D2/D3 constants, the
    two clearance functions ported from the web repo's app/geometry/interpoint.py,
    five echoed self-checks, and three range guards. Math only - no geometry reads
    it yet, double_sided is hidden and defaults to "Off", and both plates render
    byte-identical to before with the gate Off AND On.
    The section sits above the "BACKWARD COMPATIBILITY - Test System Parameters"
    marker because test_makerworld_sync compares that marker to EOF byte for byte
    and the MakerWorld variant is re-flattened in a later phase. That is also why
    the dot map exists twice (DS_DOT_MA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
    [Braille_Cylinder_STL_Generator.scad]
2026-08-19 docs(rules): record the render-and-look camera that actually frames the plates
    Both plates are translated up by cylinder_height/2 (26 mm at the default
    52 mm height), so the long-standing --camera=0,0,0,<rot>,140 aims at empty
    space below the model and cuts the top off. Phase 09 hit this while checking
    that the interpoint math changed no geometry.
    Claude-Session: https://claude.ai/code/session_01HgzKiU66kkLRBubcsSby5H
2026-08-19 feat(double-sided): Cylinder A emboss-plate geometry (Phase 10)
    With double_sided On the embossing plate now:
    - forces tactile indicators (tactile_on takes `|| ds_on`), echoes a
    WARNING when that overrode a choice, and renders a red
    DOUBLE-SIDED REQUIRES TACTILE text for the MakerWorld preview;
    - subtracts one 1.3 mm x 0.5 mm bowl per ACTUAL back-text dot, placed by
    the same transform as the web app's back_grid_transform(): the front
    angle negated (the mirror about the seam plane) plus one diagonal
    interpoint step, DS_BACK_DIRECTION * 1.25 mm around and up;
    - draws its raised dots at the fixed Option B footprint (1.2 mm base,
    0.8 mm tall), ahead of both the shape dropdown and th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
    [Braille_Cylinder_STL_Generator.scad]
2026-08-19 fix(double-sided): cut the ds bowl the way the web app does
    Brennen's decision, 2026-08-19: the web app's browser worker is the
    authoritative bowl convention, because its geometry is what has actually
    been printed and embossed. csg-worker-manifold.js sets
    radialOffset = cylRadius, i.e. the bowl's sphere centre sits ON the shell
    surface, so the printed bowl is a HEMISPHERE of radius
    DS_BOWL_R = (a^2 + h^2) / 2h - 0.6725 mm deep and 1.345 mm across at the
    shipped 1.3 / 0.5. DS_BOWL_DEPTH sets neither.
    ds_counter_recess() dropped its outward translate and DS_BOWL_CENTER_OFFSET
    is deleted; the self-check now echoes bowl_printed_mouth instead. Measured
    on the mesh: 0.4968 -> 0.6693 mm, which is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
    [Braille_Cylinder_STL_Generator.scad]
2026-08-21 feat(double-sided): key the ds footprints to paper_thickness_preset
    The web-repo counterpart of Brennen's 2026-08-20 decisions (research
    memory FD-8/FD-9; web commit b405546): the footprint print matrix showed
    one fixed footprint cannot serve both card stocks - the package that
    embosses 0.4 mm card tears 0.35 mm card, and vice versa - so the ds
    footprints now follow the paper thickness preset. Still no Customizer
    dials.
    - "0.3mm" -> Option B (dot d1.2, 0.4 base + 0.4 dome d0.8; bowl
    d1.3 x 0.5 -> cuts 0.6693 measured). Unchanged, validated on 0.3 mm
    stock 2026-08-17.
    - anything else ("0.4mm" default; "Custom" has no ds meaning) -> Q2,
    the print-matrix winner (dot d1.2, 0.5 base + 0.5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
    [Braille_Cylinder_STL_Generator.scad]
2026-08-21 feat(double-sided): Cylinder B counter-plate geometry (Phase 11)
    With double_sided On the counter plate now skips the universal recess grid
    entirely and builds the 1:1 interpoint pair instead: raised back-text dots
    (the active preset's fixed ds footprint) unioned before any recess is cut,
    one bowl per actual front-text dot at the mirrored positions, and the
    tactile arrow recesses forced as before. The back grid comes from the new
    ds_back_placements() - one shared walk serving both plates (emboss bowls at
    angle_sign +1, counter dots at -1) so the two can never drift - and
    ds_front_recesses() mirrors the emboss plate's front-dot walk. DS_PAIR
    self-check echoes (ds_fmt_e6, 1e-6 fixed point) pro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
    [Braille_Cylinder_STL_Generator.scad]
2026-08-21 feat(double-sided): promote the beta to the Customizer (Phase 12)
    The double-sided controls stop being hidden -D-only parameters. A new
    [Double-Sided Card (BETA)] tab, placed directly after [More Braille Lines
    (Advanced)], now carries the double_sided gate, Back_Line_1..Back_Line_10 and
    the two interpoint offset sliders (1.15-1.35 mm, the same range the render
    assert enforces). Nothing moved below the MakerWorld sync marker; only the
    parameter declarations moved, so ds Off stays byte-identical on all four
    captured configurations (fc /b: no differences). ds_self_check stays hidden -
    it is a test hook, not a user control - and the ds footprints stay fixed and
    keyed to paper_thickness_preset, w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
    [Braille_Cylinder_STL_Generator.scad]
2026-08-21 feat(double-sided): sign off the strings and guard the printed ridge (Phase 12 closeout)
    Brennen's four closeout decisions, recorded as FD-11.
    (1) All nine user-facing strings SIGNED OFF as written - Phase 10's three,
    Phase 11's two, Phase 12's three, and the guard message rewritten below. Every
    REVIEW-BRENNEN / "WORDING NOT YET SIGNED OFF" marker is gone; each of the eleven
    sites now reads "Wording SIGNED OFF by Brennen 2026-08-20 - reword only with his
    sign-off", and the three tests that pin the strings say the same. This closes the
    deferral chain from FD-6(b) and FD-10(a).
    (2) The hard printability assert now measures the bowl's PRINTED mouth
    (2 * DS_BOWL_R) instead of its nominal diame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
    [Braille_Cylinder_STL_Generator.scad]
2026-08-21 test(double-sided): cross-validate against the web repo's golden pair (Phase 13)
    39 new tests in tests/test_double_sided.py (53 -> 92; suite 172 -> 211 passed
    + 1 xfailed). No .scad line changed - the port needed no fix.
    THE FINDING THAT SHAPED THE PHASE. The golden pair is a SCHEMA-DEFAULT
    configuration: a solid shell of diameter 30.75 mm carrying the Option B
    footprints. This generator reaches Option B only through
    paper_thickness_preset = "0.3mm", and that preset table also carries
    cylinder_diameter_mm = 30.8 and polygon_cutout_radius_mm = 13, which
    preset_value() applies OVER any -D override (measured: passing both overrides
    produces a byte-identical STL). So the two cannot be rendered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
2026-08-21 feat(double-sided): sync the MakerWorld variant and guard its defaults (Phase 14)
    Re-flatten makerworld/Braille_Cylinder_STL_Generator_MakerWorld_v2.scad from
    the canonical file so the single-file MakerWorld build carries the whole
    double-sided beta, and widen the sync guard so parameter defaults can no longer
    drift between the two builds unnoticed.
    Ported verbatim into the variant:
    - the [Double-Sided Card (BETA)] Customizer tab: double_sided, all ten
    Back_Line fields, and both interpoint offset sliders (1.25 mm, 1.15-1.35).
    It sits above the first /* [Hidden] */ group so MakerWorld's Customizer and
    the parameter-schema validator both reach it.
    - the whole DOUBLE-SIDED (INT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
    [Braille_Cylinder_STL_Generator_MakerWorld_v2.scad]
2026-08-21 docs: release 2.6.0 - the double-sided (interpoint) beta (Phase 15)
    CHANGELOG gets a [2.6.0] entry covering the whole port: the double-sided
    Cylinder A / Cylinder B pairing, the Back_Line fields and their new
    validation coverage, the [Double-Sided Card (BETA)] Customizer tab, the
    preset-keyed footprints, the tactile seam-recess wall guard, and the
    printability guard's move onto the recess's printed mouth. Three of those
    reach single-sided renders too and are flagged as such: the two tactile
    default alignments (length 5.0 -> 10.0 mm, raise 0.8 -> 0.5 mm), the wall
    guard, and INVALID CHARACTERS now appearing on the counter plate.
    README gains a "Double-Sided Cards (BETA)" workflow section (Br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
2026-08-21 fix(geometry): fuse raised braille dots to the cylinder shell (2.6.1)
    Every raised dot was a separate connected body. The shell is a 64-sided
    prism, so each facet dips inside the ideal radius at its centre - 0.0186 mm
    on the shipped 30.8 mm cylinder - and a dot's flat base sat at exactly that
    ideal radius, spanning the dip rather than biting into it. Measured with
    trimesh: 32 bodies on the single-sided emboss default (1 shell + 31 dots),
    6 on double-sided Cylinder A, 9 on Cylinder B. Pre-existing, unrelated to
    double-sided, and the source of the negative Genus readings (FD-6c).
    DOT_BASE_EMBED lengthens each dot's base frustum downward along its own
    taper so it overlaps solid shell. Both dot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
    [Braille_Cylinder_STL_Generator.scad, Braille_Cylinder_STL_Generator_MakerWorld_v2.scad]
2026-08-22 docs(mapping): give PARAMETER_MAPPING.md the double-sided parameters it never got
    tests/parameter_mapping.json went to mapping version 2.6.0 in release 2.6.0 with
    13 new entries, but the prose mapping was never updated to match: grepping it for
    double_sided, Back_Line or interpoint returned nothing at all. This repo's stated
    convention - see the 2.5.0 CHANGELOG entry - is that the .md and the .json move
    together, and 2.6.0 broke it.
    Adds a Double-Sided Card (BETA) section covering:
    - `double_sided`, including that the wire name is the flat integer
    double_sided_enabled and that OpenSCAD accepts both the Customizer's On/Off and
    the lowercase on/off the test system passes with -D
    - Back_L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
2026-08-22 chore(release): 2.6.2 - documentation and test hygiene, no .scad touched
    No .scad file changed in this release, so every model renders byte-identically
    to 2.6.1: no geometry, dimension, parameter, default or range moved.
    scad-check reports Status: NoError, Genus 1, 11222 vertices / 22444 facets -
    identical to the 2.6.1 baseline. Suite unchanged at 224 passed, 0 xfailed.
    Collects the two preceding commits: the PARAMETER_MAPPING.md double-sided
    section the .json gained back in 2.6.0, and the conftest fixture move that
    retires the F811 suppression.
    Cut so the web repository can re-vendor docs/PARAMETER_MAPPING.md, which is one
    of the eight files it vendors from here.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
2026-08-24 fix(interpoint): one crowding line for both packages, DS_GAP_RELIABLE 0.50 -> 0.45
    Follows the web app, which made this change first after an NVDA walkthrough on
    2026-08-23 found its shipped 0.4 package (0.4678 mm nominal) sat permanently
    below the 0.50 mm line - so every double-sided run warned about a package the
    physical validation records as embossing clean.
    Investigating it found 0.50 had NO STATED BASIS in either generator or in any
    specification. It sits beside DS_GAP_FLOOR in the same comment, but the Arachne
    figures quoted there justify only the floor.
    0.45 is not a measured value either and the .scad comment says so plainly: the
    two data points that exist (0.4953 and 0.4278 mm pr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
    [Braille_Cylinder_STL_Generator.scad, Braille_Cylinder_STL_Generator_MakerWorld_v2.scad]
2026-08-24 chore(release): 2.7.0 - one crowding line for both packages
    Promotes the unreleased DS_GAP_RELIABLE change (d37078b) to a tagged release so
    the web repo can re-vendor it.
    Renders at the shipped defaults are unchanged. The only geometry difference is
    that the raised "DOTS TOO CLOSE" text can now appear for the 0.4 mm package in
    the 0.34-0.45 mm nominal band, which is reachable only by moving the interpoint
    offsets off 1.25. Measured: 27,134 facets at offset 1.25 against 32,038 at 1.21.
    Minor rather than patch because that is a behaviour change for existing users of
    the default package.
    Checks at this commit: scad-check PASSED (Status NoError, manifold, 0 lines
    containing WARNING: or ERROR: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
2026-08-25 feat(gears): vendor the gear assets in this generator's frame
    Phase 11 of the gear-integrated one-piece rollers beta, and the start of
    Sub-plan B. Nothing renders them yet - this commit only puts the meshes here so
    the .scad can import() them next.
    assets/gears_a.stl and assets/gears_b.stl are the web repo's derived binaries
    converted into THIS generator's frame. The difference between the two frames is
    the z seat and nothing else: the browser centres a cylinder on z=0 (barrel
    -26..+26, gears -36..-26 and +26..+36) while this generator seats the barrel
    base at z=0, so the assets here are the same baked geometry translated +26.000
    mm in z - gears at z -10..0 and 52..62, axis at the origin, r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
    [gears_a.stl, gears_b.stl]
2026-08-25 feat(gears): integrated gears in the desktop build, and the MakerWorld file kept in step
    Phase 12 of the gear-integrated one-piece rollers beta. `integrated_gears = On`
    now unions the vendored gears and their weld rings into either plate, forces the
    barrel solid, and welds the raised tactile arrows.
    A SCOPE DECISION BRENNEN MADE MID-PHASE. The plan said the MakerWorld variant
    would not be touched. It could not hold: tests/test_makerworld_sync.py requires
    the canonical file's geometry body (marker at line 645 to EOF) to be
    BYTE-IDENTICAL to the MakerWorld copy, and every module the gears touch -
    cylinder_shell, tactile_raised, both plate modules - is below that marker. I
    proved it before ask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
    [Braille_Cylinder_STL_Generator.scad, Braille_Cylinder_STL_Generator_MakerWorld_v2.scad]
2026-08-25 test(gears): render tests for the one-piece roller, and the v2.8.0 changelog
    Phase 13 of the gear-integrated one-piece rollers beta, closing Sub-plan B's
    code. The version bump, tag and release are Brennen's - this stops there.
    tests/test_gear_rollers_scad.py, 12 tests, all green. Nine render OpenSCAD and
    probe the STL; three are source guards that run on the no-OpenSCAD CI job.
    What they pin, and why each one earns its place:
    * ONE watertight body per plate, z -10.000..62.000, 24 tooth clusters in both
    gear bands. A wrong cylinder size does not merely look different here - the
    gears do not move with the barrel, so the part comes apart.
    * NO body with negative volume. A negati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
2026-08-25 docs(gears): record Brennen's sign-off on the customizer text and the changelog
    Comment and note changes only - not one user-facing word moved.
    GR-FD-6 says every new string ships FLAGGED for Brennen's review. Two in this
    repo were still carrying that flag: the `integrated_gears` customizer help text,
    which is what a user reads in the Customizer before switching the beta on, and
    the v2.8.0 CHANGELOG entry. He signed both as drafted on 2026-08-25.
    They now carry the same "reword only with his sign-off" line every other signed
    string here carries, so the next person to touch them knows the words are
    load-bearing rather than a draft.
    The CHANGELOG entry stays marked UNRELEASED: Brennen's sep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
    [Braille_Cylinder_STL_Generator.scad]
2026-08-25 refactor(gears): gear_set names its plate instead of reading the global
    gear_set() takes an `emboss` parameter and each plate module passes its own
    value, removing the last geometry-level read of is_emboss_plate inside the
    plate bodies. Groundwork for rendering both plates in one pass: with the
    global read, both cylinders would import the same gear STL.
    No geometry change: default and gears-on STLs for both plates are
    byte-identical to the pre-change renders (sha256-verified), scad-check
    passes on both builds, 247 tests green, MakerWorld body re-flattened.
    Claude-Session: https://claude.ai/code/session_01T5UXMMdB1nriPcLpL8mynz
    [Braille_Cylinder_STL_Generator.scad, Braille_Cylinder_STL_Generator_MakerWorld_v2.scad]
2026-08-25 feat(gears): declare the both-plates parameters, unused
    render_both_plates (Off/On) and pair_spacing_mm (10 mm, 2-50) join the
    [Plate Selection] tab of both builds, per Brennen's decision of 2026-08-25
    (new toggle + slider; plate_type untouched). Nothing reads them yet, so
    every render is bit-identical (sha256-checked at the defaults); the wiring
    lands in the next commit. Customizer wording is marked DRAFT pending
    Brennen's sign-off.
    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
    [Braille_Cylinder_STL_Generator.scad, Braille_Cylinder_STL_Generator_MakerWorld_v2.scad]
2026-08-25 feat(gears): both-plates mode renders the pair side by side
    While render_both_plates is On, MAIN RENDERING builds Cylinder A
    (embossing plate) at -X and Cylinder B (counter plate) at +X, centres
    active_cylinder_diameter_mm + pair_spacing_mm apart, so the barrel
    surfaces sit exactly the slider's distance from each other. plate_type is
    ignored while On, the console says so (NOTE:, never WARNING:), and the
    pair hint suggests Cylinder_Pair_<name>.stl; the signed double-sided
    per-plate hint is gated to !both_on - condition change only, wording
    untouched, FLAGGED for Brennen. Echo wording is DRAFT pending sign-off.
    Interactions that need no code, stated for the record: the gear size
    assert is fil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
    [Braille_Cylinder_STL_Generator.scad, Braille_Cylinder_STL_Generator_MakerWorld_v2.scad]
2026-08-25 test(gears): render coverage for the both-plates pair
    Seven tests: two watertight bodies with centres diameter + gap apart
    (measured from centroids - bounding boxes lie by a dot height), lowercase
    toggle accepted, the spacing slider followed (20 mm -> 50.8 centres),
    both cylinders full 72 mm rollers in gear mode, the double-sided per-
    plate hint standing aside for the single pair hint, the file-scope size
    gate refusing an off-size geared pair exactly ONCE with no STL, and the
    two new parameters staying out of the preset tables (trap C3).
    Full suite 254 passed.
    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
2026-08-25 docs: why rendering feels slow, and what actually helps
    Measured 2026-08-25 on the reference machine: stable 2021.01 takes over
    ten minutes (CGAL) for the counter plate Nightly renders in ~2 s, so the
    first check is which binary opened the file. Inside Nightly the F5
    preview re-pays 0.5-1 s per FRAME while rotating (OpenCSG re-evaluates
    the 312-sphere universal grid every redraw) while F6 stays fast - so the
    section separates the two costs and warns that render_quality=Low is a
    real geometry change, not a preview trick.
    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
2026-08-25 docs(changelog): both-plates mode, the perf section, gear_set param
    Under [Unreleased], not inside the signed 2.8.0 block - whether these
    fold into 2.8.0 before it tags is Brennen's call, and the entry wording
    is marked DRAFT for his sign-off.
    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
2026-08-25 docs: the 2021.01 measurement finished - 45 minutes and counting
    The stable-release render of the counter plate was stopped at 45 minutes
    still unfinished (Nightly: 1.8 s), so the README section now says so
    instead of the interim "over ten minutes".
    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
2026-08-25 chore: apply Brennen's 2026-08-25 sign-off and add the S9 hardware note
    The pair-mode gate closed with every draft approved as written, so the
    DRAFT markers on render_both_plates, pair_spacing_mm, the pair echoes,
    and the CHANGELOG [Unreleased] block become signed-off comments (both
    builds; MakerWorld body re-flattened from the desktop file). He also
    approved keeping the two new params visible in MakerWorld's Plate
    Selection and silencing the per-plate filename echo while both-mode is
    on.
    New in this commit (O9): the signed S9 hardware warning - integrated
    gears fit only version 2 of the braille embosser hardware, not
    version 1 - as customizer text above integrated_gears (with a
    placeholder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
    [Braille_Cylinder_STL_Generator.scad, Braille_Cylinder_STL_Generator_MakerWorld_v2.scad]
2026-08-25 fix(pair): render() each body so the both-plates preview cannot empty
    Brennen's GUI log showed the both-plates preview intermittently dying
    with "Normalized tree is growing past 200000 elements. Aborting
    normalization" then "CSG normalization resulted in an empty tree" - a
    blank preview with no visible error. Reproduced deterministically with
    both plates + gears + double-sided (CLI cap 100k). Two whole plates
    under one OpenCSG preview tree normalize combinatorially; whether the
    cap trips depends on the dial combination, so it looked random.
    Each body in the both_on branch is now wrapped in render(): evaluated
    once to a mesh (Manifold, ~2 s) and the preview tree stays at TWO
    elements no matt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
    [Braille_Cylinder_STL_Generator.scad, Braille_Cylinder_STL_Generator_MakerWorld_v2.scad]
2026-08-26 fix(quality): rank the hemisphere_quality override above the render_quality dropdown
    quality_fn had both inputs interleaved in one ternary chain:
    (hemisphere_quality == "low" || render_quality == "Low") ? 24 :
    (hemisphere_quality == "medium" || render_quality == "Medium") ? 32 :
    (hemisphere_quality == "high" || render_quality == "High") ? 64 : 32;
    With the shipped default render_quality "Medium" standing, hemisphere_quality
    "high" fell through arm 1, then matched "Medium" in arm 2 and returned 32. The
    64 arm could not be reached at all. Measured on one short line before and after:
    "high" rendered 8,976 triangles - byte-for-byte what "medium" renders - and now
    renders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
    [Braille_Cylinder_STL_Generator.scad, Braille_Cylinder_STL_Generator_MakerWorld_v2.scad]
2026-08-26 fix(dots): overlap the rounded dome with its frustum instead of touching it
    This is the second tangency inside every rounded dot, reported under 2.6.1's
    known issues on 2026-08-21 and left open since.
    The spherical cap was cut off at exactly the frustum's top plane. That plane is
    not arbitrary: rearranging the cap formula R = (r^2 + h^2) / 2h shows the cap's
    base circle there has exactly the frustum's top radius. So the two halves of
    every rounded dot met on one shared circle, with no overlap, tessellated
    differently either side of it - cone_segments 16 against quality_fn 24/32. The
    union welded them, but by coincidence rather than construction, which is what
    the file's own "overlap, never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
    [Braille_Cylinder_STL_Generator.scad, Braille_Cylinder_STL_Generator_MakerWorld_v2.scad]
2026-08-26 docs(makerworld): say that integrated gears are not in this build, and why
    Until now the MakerWorld build simply had no gears control - declared, hidden,
    never mentioned to the person using it. Someone who had seen the feature in the
    desktop build or the web app had no way to tell whether they were missing a
    setting, using the wrong file, or hitting a bug. Brennen chose to say it out
    loud instead.
    makerworld/README.md gains a short section: the gears are a separate mesh file,
    MakerWorld's customizer cannot accept one, and here are the two places that do
    have them - the desktop build with its assets/ folder, and the web app. It also
    repeats the version-2 hardware warning, because the people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
    [Braille_Cylinder_STL_Generator_MakerWorld_v2.scad]
2026-08-26 docs: document the gears, both-plates mode, and three unmapped parameters
    The README had zero occurrences of the word "gear". Integrated gears are the
    headline feature of the unreleased 2.8.0 and the main entry point for the whole
    project said nothing about them - not what they do, not that the cylinder is
    locked to 30.8 x 52 while they are on, not that they need the assets/ folder,
    and not the version-2 hardware warning. Same for render_both_plates and
    pair_spacing_mm: the only "both plates" text in the file described the OLD
    render-each-separately workflow, which now reads as contradicting the feature.
    Added to README.md: an Integrated Gears (BETA) section leading with the signed
    version-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
2026-08-26 chore: apply Brennen's sign-off to this session's new strings
    All four items approved as written on 2026-08-25: the README's Integrated Gears
    and Rendering Both Plates sections, makerworld/README.md's "gears are not in
    this build" section and the hidden parameter's comment behind it, and the three
    new CHANGELOG entries (hemisphere_quality, the rounded-dome weld, and the
    MakerWorld gears finding).
    DRAFT markers become signed-off-date comments in house style. The hardware
    sentence in both READMEs is his signed S9 text reused verbatim, and says so.
    Comments and prose only: scad-check PASSED on both builds, 258 pytest green.
    Claude-Sessio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
    [Braille_Cylinder_STL_Generator_MakerWorld_v2.scad]
2026-08-29 feat(v2): add the self-contained Embosser Version 2 OpenSCAD file
    NEW Braille_Cylinder_STL_Generator_EmbosserV2.scad, 2340 lines, built FROM the
    canonical v1 file so every braille feature, dot shape, preset value, indicator
    and double-sided behaviour is identical, then changed to exactly what Version 2
    changes. The v1 files are untouched: git diff against
    Braille_Cylinder_STL_Generator.scad, presets.scad and makerworld/ is empty.
    What differs: a keyed through-cutout at both ends instead of the polygonal one;
    a 3 mm triangular key nub on the Embossing Plate's top face; the preset barrel
    is 30.1 x 52; one new dial, key_clearance_mm (0-0.5, default 0.15); no
    Integrated Gears (that beta builds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
    [Braille_Cylinder_STL_Generator_EmbosserV2.scad]
2026-08-29 docs(v2): record S-V11 as signed in the Version 2 OpenSCAD file
    Brennen signed the Version 2 file's user-facing copy as drafted on 2026-08-28:
    the header block, the [Version 2 Keyed Cutouts] tab comment, the two NOTE:
    echoes, and the wall warning re-pointed from the polygonal cutout to the keyed
    hole. Offered a shorter header and a quieter console instead, he kept both -
    the what-differs list stays for a MakerWorld user opening the file, and the
    prototype sentence keeps printing on every render so a CLI or batch user is
    told too.
    Comment-only: the four FLAGGED FOR BRENNEN markers become sign-off lines. No
    geometry, no parameter and no rendered byte changes - CHECK PASSED again with
    Status N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
    [Braille_Cylinder_STL_Generator_EmbosserV2.scad]
2026-08-29 test(v2): cover the Version 2 OpenSCAD file, and document it
    NEW tests/test_embosser_v2_scad.py - 18 tests, all passing, driving the .com
    wrapper directly and judging by output text and file existence rather than exit
    codes, because two of them assert on a render that is SUPPOSED to fail.
    What it pins: both plates render clean and export ONE body; the keyed cutout is
    a genuine THROUGH-hole (the axis is air from end to end); each of the four
    pockets is its own R14 key at the clearance actually rendered, with a FLAT
    facing the tactile arrow column; all four mouths carry the same 45 degree
    countersink, probed at 0.1, 1.0 and 1.9 mm below each face; the nub is on
    Cylinder A only, apex on the co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
2026-08-29 docs(s9): re-sign the gear hardware note as S9'
    "Version 2" now names the KEYED-PEG embosser, so S9's old sentence - that
    integrated gears "fit only version 2 of the braille embosser hardware" - points
    at the one thing those gears definitely do not fit. They fit the one-piece
    geared-roller housing, which is neither embosser body.
    New wording, signed by Brennen 2026-08-28:
    "Integrated gears fit only the one-piece geared-roller housing. They do not
    fit the Version 1 or Version 2 embosser bodies."
    Changed in the customizer tab comment and the console echo, and the same echo
    in the MakerWorld single-file build so the two stay byte-identical. Copy only -
    no geometry, no parameter, no defau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
    [Braille_Cylinder_STL_Generator.scad, Braille_Cylinder_STL_Generator_MakerWorld_v2.scad]
2026-08-30 fix(v2): 30.5 mm barrel, 0.075 mm key clearance, nub off the dial
    Mirrors the web repo's first Version 2 print round. Same three changes,
    same reasons, so the two generators cannot drift.
    BARREL 30.1 -> 30.5 mm. The printed 30.1 pair embossed with noticeably
    less pressure than Version 1; 30.5 is half way back toward Version 1's
    30.8. Changed in the header note, the Expert Mode comment,
    cylinder_diameter_mm, the self-contained preset tables (both) and the
    soft size echo.
    KEY CLEARANCE 0.15 -> 0.075 mm, Customizer step 0.01 -> 0.005. All four
    peg holes printed too loose, and the pegs measure exactly nominal. The
    step had to move with the default: a Customizer range whose step does
    not divide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
    [Braille_Cylinder_STL_Generator_EmbosserV2.scad]
2026-08-30 feat(v2): mirror the anti-rotation keys into the Version 2 .scad
    Every gear gained an anti-rotation feature in print round 2, so both plates now
    stand a nub above their top face and sink a socket into their bottom one, and
    the key clearance moves 0.075 -> 0.110. This mirrors the web repository's
    app/geometry/version2.py name for name, as this file has done since it was
    written.
    Constants: V2_ANTIROT_CLEARANCE = 0.15 (fixed, no dial), V2_GEAR_TRIANGLE_INSET
    = 0.15 (measured off the printed gears), V2_ANTIROT_B1_NOTCH / V2_ANTIROT_B2_PIN
    (B's squares, also measured), V2_SOCKET_MAX_RADIUS = 14.0, V2_SOCKET_DEPTH
    derived as V2_NUB_HEIGHT + V2_ANTIROT_CLEARANCE, V2_NUB_BASE_FLARE 0.5 -> 0.10,
    an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
    [Braille_Cylinder_STL_Generator_EmbosserV2.scad]
2026-08-31 fix(v2): mirror the 30.8 mm barrel into the Version 2 .scad
    The preset, both preset tables, the live size note and the header comment,
    matching app/geometry/version2.py in the web repo. The header no longer claims
    the cylinder preset differs from Version 1's - since 2026-08-30 it does not, so
    the list of differences is down to one entry.
    The size-note test's off-size example moves 30.8 -> 30.5 for the same reason:
    30.8 is now the preset, so at that size no note fires and the old example would
    have proved nothing.
    Nothing about the keys moved. Every keyed hole and every anti-rotation feature
    is at a fixed radius from the cylinder axis, so the barrel change does not
    touch them.
    279 pytest,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
    [Braille_Cylinder_STL_Generator_EmbosserV2.scad]
2026-09-01 feat(v2): the barrel grows to 54 mm and the text input trims to 4 rows per face
    Braille_Cylinder_STL_Generator_EmbosserV2.scad only; every Version 1
    file is untouched (the guard test proves it). Mirrors the web app,
    where the 54 mm barrel became Version 2's alone on 2026-08-31 - the
    project-wide default returned to Version 1's 52 the same day
    (braille-cylinder-stl-generator 23d95fd).
    - Barrel 30.8 x 54: the height dial, both preset tables and the size
    note. The extra 2 mm is a 1 mm shelf past each edge of the 52 mm
    card; the rows center themselves in the height and every keyed
    feature places from height/2, so nothing moves relative to its face.
    - Text input is Line_1-4 and Back_Line_1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
    [Braille_Cylinder_STL_Generator_EmbosserV2.scad]
2026-09-01 fix(makerworld): finish the v1.5 rename Brennen started, and draft the Version 2 listing
    He renamed makerworld/Braille_Cylinder_STL_Generator_MakerWorld_v2.scad
    to ..._MakerWorld_v1.5.scad (byte-identical content) because the old _v2
    suffix - the second generation of the MakerWorld FILE - had become
    muddled with Embosser Version 2, which is different hardware. The rename
    alone broke the Version 2 suite: its Version-1-files-untouched guard
    watches that exact path, so test_the_version1_files_were_not_touched
    failed on the 2280-line deletion. That is the "Version 2 error" hit when
    testing locally on 2026-09-01.
    - Every reference follows the new name: five test files (the V2 guard,
    the MakerW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
    [Braille_Cylinder_STL_Generator_MakerWorld_v1.5.scad]
2026-09-01 feat(makerworld): the Version 2 upload gets its own file in makerworld/
    makerworld/Braille_Cylinder_STL_Generator_MakerWorld_v2.scad, on
    Brennen's direction: the makerworld/ folder now holds the upload for
    every listing, _v1.5 for the Version 1 model and _v2 for Embosser
    Version 2 - the _v2 suffix now means what it sounds like, completing
    the de-muddle his rename started.
    The file is a COPY of the canonical root _EmbosserV2 file. Because the
    canonical file is self-contained there is no flattening step and no
    allowed difference: the copy is byte-identical, and the new
    test_the_makerworld_copy_is_byte_identical fails the suite if the two
    ever drift. After editing the canonical file, re-copy i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
    [Braille_Cylinder_STL_Generator_MakerWorld_v2.scad]
2026-09-01 docs(v2): record Brennen's 54 mm print inspection and wording sign-off
    Both cylinders printed from the Version 2 file at 30.8 x 54 passed his
    inspection on 2026-09-01, and he signed the 2026-08-31 wording revisions
    the same day. The labels that were calling for his attention follow:
    - The .scad's two sign-off tags (the S-V11 header block and the
    keyed-cutouts tab) now record the 2026-09-01 sign-off; the makerworld
    copy is re-copied so the byte-identity guard stays green.
    - CHANGELOG's "Not print-tested at 54" becomes the inspection record.
    - The listing draft loses its 54 mm warning (its own removal condition
    is met), ticks the print-test checklist item, and drops the
    KNOWN_ISSUES c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
    [Braille_Cylinder_STL_Generator_EmbosserV2.scad, Braille_Cylinder_STL_Generator_MakerWorld_v2.scad]
2026-09-01 docs(v2): the 54 mm print test is passed - finish the claim
    Brennen confirmed it ("Print test have been passed") after the labels
    had deliberately said only print-INSPECTED: the 30.8 x 54 pair printed
    from the Version 2 file has now passed the print test. The CHANGELOG
    bullet and the listing draft's checklist item say so plainly.
    Checks: ruff and ruff format --check clean; full suite 282 passed.
    Claude-Session: https://claude.ai/code/session_01ToHWDJ6arzzbB6qoAwyphR
2026-09-01 fix(v2): strip development tags from the public file - they were showing on dials
    The OpenSCAD Customizer renders the comment block directly above a
    parameter as that dial's on-screen description, so the internal
    "Wording SIGNED OFF by Brennen ... reword only with his sign-off"
    bookkeeping was showing to end users - Brennen caught one on a dial.
    Braille_Cylinder_STL_Generator_EmbosserV2.scad only, plus its
    byte-identical makerworld copy.
    - Every sign-off label and dated approval parenthetical is removed,
    from dial descriptions and internal comments alike (25 sites).
    - The key-clearance dial's description is now the clean user wording
    (mirroring the web app's dial note); the engineering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
    [Braille_Cylinder_STL_Generator_EmbosserV2.scad, Braille_Cylinder_STL_Generator_MakerWorld_v2.scad]
2026-09-20 feat(tactile): the 0.3mm preset marks its cylinders with three fixed seam arrows
    The tactile seam arrows now tell the two paper-thickness presets apart by
    touch. "0.4mm" keeps one arrow per braille row, byte-identical to before;
    "0.3mm" places exactly three arrows at mid-height and 15 mm above and below
    it (TACTILE_THREE_SPACED_PITCH), whatever the row count, so a blind user
    can count them and a 0.3mm cylinder will not nest with a 0.4mm one.
    "Custom" keeps one per row: it is an explicit choice in this Customizer.
    - tactile_three_spaced = (paper_thickness_preset == "0.3mm"); both row
    modules draw their heights from one tactile_arrow_y_positions() function,
    so the counter recesses can nev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
    [Braille_Cylinder_STL_Generator.scad, Braille_Cylinder_STL_Generator_EmbosserV2.scad, Braille_Cylinder_STL_Generator_MakerWorld_v1.5.scad, Braille_Cylinder_STL_Generator_MakerWorld_v2.scad]
2026-09-21 test(seam-channel): the pre-channel baseline of the four default plates (Phase O0)
    Phase O0 of the OpenSCAD parity plan (follow-on to the web app's 2026-09-20
    programme; plan approved by Brennen 2026-09-21). Records a geometry signature
    - triangle count, unique vertex count, sha256 of the unique vertices rounded
    to 1e-5 mm, volume and area - of the Version 1 and Version 2 embossing and
    counter plates at their defaults, rendered with the exact command the new
    tests/test_seam_channel_scad.py uses (--hardwarnings
    --check-parameter-ranges=true --export-format binstl, -D plate_type and
    -D seam_channel="Off", which is inert until O1). From O1 on, seam_channel=Off
    must reproduce that geometry.
    Why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
2026-09-21 feat(seam-channel): the Version 1 file cuts the slicer seam channel (Phase O1)
    Parity with the web generator's 2026-09-20 seam channel (web decisions D-1,
    D-2, D-13..D-15): a V groove 1.0 mm wide x 0.5 mm deep the full height of the
    outer surface, in the seam gap beside the row-indicator column, On by
    default, so a slicer's "aligned" seam mode hides each layer's seam in it
    instead of in a braille dot.
    The .scad mirrors app/geometry_spec.py one for one: the six SEAM_CHANNEL_*
    constants, the footprint / free-window / wall rules and the two omission
    sentences S-C2 / S-C3 (the web's signed words, echoed as NOTE). The groove is
    cut from the bare outer cylinder before the polygon cutout and befor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
    [Braille_Cylinder_STL_Generator.scad, Braille_Cylinder_STL_Generator_MakerWorld_v1.5.scad]
2026-09-21 feat(seam-channel): the Version 2 file cuts the slicer seam channel (Phase O2)
    The same port as O1 into the self-contained Version 2 file: the switch in
    the Cylinder Dimensions tab (the tab's third control - Version 2 offers no
    cutout or seam-offset dials), the six SEAM_CHANNEL_* constants and the
    placement block in the Hidden section, seam_channel_cut() as the FIRST cut in
    cylinder_shell_v2() - before the keyed halves, the mouths and the socket - one
    physical angle per plate, the slot-7 badge and the NOTE echoes. The wall rule
    is kept for parity and can only pass here: the keyed bore's corners reach at
    most 10.7 mm, the nub 14.3 and the socket 14.0, all inside the 14.9 mm groove
    floor, and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
    [Braille_Cylinder_STL_Generator.scad, Braille_Cylinder_STL_Generator_EmbosserV2.scad, Braille_Cylinder_STL_Generator_MakerWorld_v1.5.scad, Braille_Cylinder_STL_Generator_MakerWorld_v2.scad]
2026-09-21 feat(gears): vendor the Version 2 fixed-gear pair as STL assets (Phase O4)
    assets/v2_gears_a.stl and v2_gears_b.stl are derived 1:1 from the web repo's
    static/assets/gears/v2_gears_{a,b}.bin (scripts/derive_gear_assets_v2.py,
    Brennen's v8 Version 2 gears, every axis measured per gear) by the same
    regenerate() that makes the Version 1 pair, now table-driven over both
    asset sets: the Version 2 frame shift is +27.000 mm (the browser centres the
    54 mm barrel on z 0), so the gear bodies sit at z -10..0 and 54..64 with the
    15 mm keyed pegs inside the barrel. GEARS_PROVENANCE.json gains the two
    entries, a "v2" frame block and v2_source_samples (four distinct source
    hashes); the Version 1 entries ar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
    [v2_gears_a.stl, v2_gears_b.stl]
2026-09-21 feat(v2): fixed gears in the Version 2 file (parity phase O5)
    Braille_Cylinder_STL_Generator_EmbosserV2.scad gains an [Integrated Gears]
    Customizer switch, Off by default. On, cylinder_shell_v2 builds the plain
    solid barrel (no keyed halves, mouths or socket; the seam channel is still
    cut first), the nub is left off, and gear_set_v2 unions
    assets/v2_gears_a|b.stl shifted by -h/2, the two r 8..13 x 0.1 mm weld
    rings and the top-gear notch fill: the raw notch outline (A the inset
    triangle, B the measured square) grown 0.05 mm as an exact parallel curve,
    its reach asserted under 13.95 mm. The 30.8 x 54 size gate is a hard stop
    with the web generator's S-G1 sentence; the housing NOTE is draft S-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
    [Braille_Cylinder_STL_Generator_EmbosserV2.scad, Braille_Cylinder_STL_Generator_MakerWorld_v2.scad]
2026-09-21 feat(makerworld): the Version 2 upload joins the three-layer sync model (parity phase O6)
    makerworld/Braille_Cylinder_STL_Generator_MakerWorld_v2.scad is no longer a
    byte copy of the canonical EmbosserV2 file: like the v1.5 build it carries
    the geometry body byte-identical from the BACKWARD COMPATIBILITY marker to
    EOF and every declaration above it equal, with two presentation
    differences above the marker - a MakerWorld header block and the
    integrated_gears switch declared in the first Hidden tab (with the reason
    beside it), because MakerWorld cannot ship the gear assets (D-P1 a).
    tests/test_makerworld_sync.py runs its body and declaration layers over
    both pairs (ids v1.5 and v2); the V2 by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
    [Braille_Cylinder_STL_Generator_EmbosserV2.scad, Braille_Cylinder_STL_Generator_MakerWorld_v2.scad]
2026-09-21 docs: seam channel, Version 2 fixed gears and the MakerWorld V2 sync model (parity phase O7)
    README (Slicer Seam Channel feature section, the seam printing tip, the
    Version 2 fixed-gear paragraph, the MakerWorld v2 upload, the Version 2
    troubleshooting note), docs/PARAMETER_MAPPING.md (seam_channel row and
    paragraph under Cylinder Dimensions; integrated_gears present in Version 2;
    the fused roller), tests/parameter_mapping.json (hand-edited: seam_channel
    entry, the integrated_gears note, version_2_file no longer lists
    integrated_gears, last_updated, a notes line - the schema validator now maps
    all 63 Customizer parameters), docs/OPENSCAD_COORDINATE_SYSTEM_SPECIFICATIONS.md
    section 3.6 (the g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
2026-09-21 docs(release): 2.8.0 release notes
    The tag v2.8.0 was cut on a96c0ee (every source, asset and doc file is final
    there); this commit adds what the release habit puts beside a tag: the
    CHANGELOG's Unreleased block folds into [2.8.0] - 2026-09-21 together with the
    integrated-gears beta entries that had been waiting for it, and the README
    version and date are bumped. Tagged and released on Brennen's go-ahead after
    his print tests passed.
    Renders at the shipped defaults CHANGE in 2.8.0: every cylinder carries the
    slicer seam channel (seam_channel = "Off" restores the 2.7.0 geometry byte
    for byte, pinned by tests/fixtures/seam_channel/), and the Version 2 file's
    preset barrel is 30.8 x 54 mm with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
2026-09-21 feat(tactile): the seam arrow sits a fixed lead-in before the first cell (parity T6)
    Both files, the MakerWorld copies with them (v1.5 re-flattened, v2 re-synced):
    the tactile arrow no longer sits at the 180 degree seam-gap centre but
    tactile_indicator_width/2 + tactile_recess_clearance +
    TACTILE_LEAD_IN_MARGIN_MM (1.0) + the cell's dot footprint (5.35 mm at the
    0.4mm preset) before the first cell, at the PHYSICAL angle 180 + s/R on the
    emboss plate and 180 - s/R on the counter plate - the recess now placed
    outside the mirror at its own angle, so the pair still meets at the nip
    (web decisions D-T1..D-T4, after Brennen's printed 14-cell card ran out of
    paper at the end of every row while its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
    [Braille_Cylinder_STL_Generator.scad, Braille_Cylinder_STL_Generator_EmbosserV2.scad, Braille_Cylinder_STL_Generator_MakerWorld_v1.5.scad, Braille_Cylinder_STL_Generator_MakerWorld_v2.scad]
2026-09-21 feat(tactile): the arrow back at the seam-gap centre; the tactile seam channel runs down the arrow column (D-T6)
    Brennen's test of the lead-in build (a7585cc's web counterpart) showed the
    groove beside the arrows and a large trailing space after the last cell; he
    asked for the groove centred on the arrows and the spacing back to even.
    Both .scad files and both MakerWorld copies:
    - the arrow sits at 180 on both plates again (tactile_surface_prism(y_pos,
    span) places it with place_cylinder_marker(180, ...)); the lead-in
    constant, helpers and NOTE are gone;
    - in Tactile mode the seam channel is cut at 180 as two stretches that stop
    SEAM_CHANNEL_ARROW_MARGIN_MM (0.3) short of the arrow ch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
    [Braille_Cylinder_STL_Generator.scad, Braille_Cylinder_STL_Generator_EmbosserV2.scad, Braille_Cylinder_STL_Generator_MakerWorld_v1.5.scad, Braille_Cylinder_STL_Generator_MakerWorld_v2.scad]
2026-09-22 feat(tactile): the seam channel runs the full height and is recut through the raised arrows (D-T7)
    Brennen's print of the D-T6 build: wherever the groove stopped short of the
    arrow chain the slicer chose a braille dot or a bowl for its seam. His
    instruction: extend the channel through the triangles and between them
    along the axis; his choice for the cut through each raised arrow: the same
    V, its sides continued (2 mm wide at the arrow's top face, so each arrow
    keeps its base half as two ridges and loses its point).
    Both .scad files and both MakerWorld copies: the tactile groove is the
    full-height cut again on both plates (the stretches and the S-C4 "no room"
    note and badge are gone); seam_c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
    [Braille_Cylinder_STL_Generator.scad, Braille_Cylinder_STL_Generator_EmbosserV2.scad, Braille_Cylinder_STL_Generator_MakerWorld_v1.5.scad, Braille_Cylinder_STL_Generator_MakerWorld_v2.scad]
2026-09-22 chore(v2): drop the prototype note; rename the seam-column render suite
    Brennen's decisions (2026-09-21): the Version 2 file and its MakerWorld
    copy no longer echo the "work-in-progress prototype" note (the web app
    dropped the label on 2026-09-20); tests/test_tactile_lead_in_scad.py becomes
    test_tactile_seam_column_scad.py, contents unchanged.
    Claude-Session: https://claude.ai/code/session_01AoF5M6bJrPopgFRuzVNjyf
    [Braille_Cylinder_STL_Generator_EmbosserV2.scad, Braille_Cylinder_STL_Generator_MakerWorld_v2.scad]
2026-09-22 docs(v2): drop the "prototype" wording (Brennen, 2026-09-21)
    The Version 2 file's header (and the MakerWorld copy's), the README's
    troubleshooting section, the MakerWorld README and the listing draft now say
    the barrel and cutouts are print-tested instead of calling the design a
    work-in-progress prototype. The signed S-V12 title and S-V13 status sentence
    are reworded on his instruction and marked so in the draft.
    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
    [Braille_Cylinder_STL_Generator_EmbosserV2.scad, Braille_Cylinder_STL_Generator_MakerWorld_v2.scad]
2026-09-23 feat(tactile): the seam channel steps round the raised arrows instead of through them (D-T8)
    Brennen's testing of the D-T7 groove, which recut the V through each
    raised arrow, found the cut took the arrows' points and made the triangles
    less distinguishable by touch. The web generator changed on 2026-09-22
    (decision D-T8, his choices: the first-cell side, 0.25 mm of flat between
    arrow and groove, a 45 degree slant, and the groove left out with a signed
    note where there is no room); this brings both files and both MakerWorld
    builds into line with it.
    Both .scad files: seam_channel_detour_path is the web generator's
    _tactile_detour_path() ported line for line (seam_detour_arc / _one /
    _x_at /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
    [Braille_Cylinder_STL_Generator.scad, Braille_Cylinder_STL_Generator_EmbosserV2.scad, Braille_Cylinder_STL_Generator_MakerWorld_v1.5.scad, Braille_Cylinder_STL_Generator_MakerWorld_v2.scad]
2026-09-23 docs(release): 2.8.2 release notes
    The tactile seam channel steps round the raised arrows instead of cutting
    through them (web decision D-T8), and a Tactile layout with no room for the
    detour leaves the groove out with the signed S-C5 note - both files and both
    MakerWorld builds, groove for groove with the web generator. Tagged on
    Brennen's instruction of 2026-09-23 to bring the OpenSCAD version into line
    and release it as v2.8.2 for re-vendoring. The [Unreleased] "prototype"
    wording removals ship in this release too.
    Claude-Session: https://claude.ai/code/session_016XBgtN2WC978id2hvBdbRL
2026-09-23 feat(customizer): in line with the web app - both cylinders by default, its section names, no BETA or sign-off labels
    Brennen asked (2026-09-23) for the root project and the MakerWorld
    standalone builds to be brought in line with the updated web app, and chose
    each option: both cylinders by default, the web's section names with the
    dial names kept, the sign-off labels removed, and a release with PRs to main.
    All four public .scad files (both roots, both MakerWorld builds):
    - render_both_plates defaults to "On": one render is the pair, Cylinder A on
    the left and Cylinder B on the right, as the web app's Generate builds
    both. plate_type still picks one plate when it is Off.
    - Section titl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
    [Braille_Cylinder_STL_Generator.scad, Braille_Cylinder_STL_Generator_EmbosserV2.scad, Braille_Cylinder_STL_Generator_MakerWorld_v1.5.scad, Braille_Cylinder_STL_Generator_MakerWorld_v2.scad]
2026-09-23 docs(release): 2.9.0 release notes
    In line with the web app again: both cylinders by default, the web app's
    section names, no BETA labels, no sign-off labels in the public files, and
    the web app's current gear hardware note. The README follows - the pair
    default in the quick start, the double-sided workflow and the both-plates
    section, the renamed headings and their anchors, the timings, and the
    Version 1 gear note, which still carried a pre-2026-08-28 sentence that named
    the wrong hardware. Tagged on Brennen's instruction of 2026-09-23 to release
    it and open PRs to main in both repos.
    Claude-Session: https://claude.ai/cod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
2026-09-24 docs(quick-start): a diameter instruction that works, and the wall figure at defaults
    Brennen chose (2026-09-23) to fix the two quick-start problems reported with
    v2.9.0.
    The sizing step named a dial that does not exist (`cylinder_diameter`) and
    never said that the 0.4mm and 0.3mm presets fix the diameter at 30.8 mm and
    ignore the slider: at the default preset a typed 55 still renders 30.8, and
    only paper_thickness_preset = Custom lets it through (checked with an echo
    probe of active_cylinder_diameter_mm). The step and the spice-jar example
    now name cylinder_diameter_mm and the Custom preset, and the preset bullet
    says presets set the cylinder dimensions too.
    The tactile recess wall at def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
2026-09-24 docs(release): 2.9.1 release notes
    Documentation only - no .scad file changed, so every model renders exactly
    as in 2.9.0: the quick start's diameter instruction names the real dial and
    the Custom preset it needs, and the tactile recess wall at defaults is given
    as about 1.22 mm in the quick start and the parameter mapping. Tagged on
    Brennen's decision of 2026-09-23 to fold these fixes in before merging to
    main.
    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
2026-09-24 docs(makerworld): the Version 2 upload's hidden gear note names the [Gears] tab
    Found in the post-release review: the comment above the hidden integrated_gears declaration in the MakerWorld Version 2 upload still said the desktop file offers the switch under [Integrated Gears], the tab renamed to [Gears] in v2.9.0. Comment only, above the sync marker - no geometry, dial or default changed; scad-check passes and the full suite is 382 passed.
    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
    [Braille_Cylinder_STL_Generator_MakerWorld_v2.scad]
2026-09-25 feat(v2): fused roller - barrel chamfer, axis vent and self-supporting gear socket (O1)
    Parity with the web generator's 2026-09-24 programme (its decisions D-1, D-2, D-6): with integrated_gears On, cylinder_shell_v2 chamfers the barrel's bottom edge 0.65 mm x 45 deg right after the seam channel (fused_barrel_chamfer, a revolved right triangle with a 1 mm lip), and both plate modules subtract fused_axis_cuts LAST - the 2 mm vent the whole roller's length plus 1 mm out of each mouth, and the cone that continues each bottom socket's 45 deg taper (A: rim 5.3, B: rim 3.3, ceiling 1.5 below the barrel face, measured off the v8 gear assets) up to the vent, so the socket ceiling prints with no suppo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
    [Braille_Cylinder_STL_Generator_EmbosserV2.scad, Braille_Cylinder_STL_Generator_MakerWorld_v2.scad]
2026-09-25 feat(v2): Tactile is the Version 2 Customizer default (O2, web D-4)
    Parity with the web generator's 2026-09-24 decision D-4: the Embosser Version 2 file and its MakerWorld copy declare indicator_mode = "Tactile" (the description says so and that the Version 1 file keeps Visual - S-O2 in the web programme's decisions file); the two Version 1 files are untouched, and a new guard in tests/test_embosser_v2_scad.py pins all four defaults. Tests that assert VISUAL-mode facts of the Version 2 file are pinned to indicator_mode Visual rather than loosened: the keyed plates as one watertight body (a tactile emboss plate's chained raised arrows touch apex to base exactly - measured one body with three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
    [Braille_Cylinder_STL_Generator_EmbosserV2.scad, Braille_Cylinder_STL_Generator_MakerWorld_v2.scad]
2026-09-25 docs(release): 2.10.0 release notes
    The fused Version 2 roller's v9 update (chamfer, axis vent, self-supporting gear socket - O1, bb332d7) and the Version 2 Customizer's Tactile default (O2, 935289b), in parity with the web generator's 2026-09-24 programme. The [Unreleased] MakerWorld comment fix rides in this release. README version 2.10.0, last updated 2026-09-24. Verified before this commit: full suite 387 passed, cross-platform validation 74 passed, both Version 2 files CHECK PASSED at defaults and the fused roller with gears On on both plates.
    Claude-Session: https://claude.ai/code/session_01VD2LVofqHGxneFR9e1qoyp
2026-09-25 feat(v2): one key clearance dial per gear, default 0.095 mm
    Parity with the web generator's 2026-09-25 change. Only the Embosser Version
    2 file and its MakerWorld copy change; the Version 1 files are untouched.
    - [Version 2 Keyed Cutouts]: key_clearance_a1_mm, _a2_mm, _b1_mm, _b2_mm
    (each 0.095; // [0:0.005:0.5], its own Customizer description) replace the
    shared key_clearance_mm, which is retired. 0.095 is what a printed round
    confirmed for gears A2 and B2 (cylinders on Bambu Studio 0.12 mm Fine
    Detail, gears on 0.2 mm Strength); the old 0.110 printed a touch loose.
    - Four range asserts; v2_key_clearance(key) maps a key to its dial (an
    unknown key stops the render); keyed_half_cu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
    [Braille_Cylinder_STL_Generator_EmbosserV2.scad, Braille_Cylinder_STL_Generator_MakerWorld_v2.scad]
2026-09-26 feat(v2): defaults A1/B1 0.075, A2/B2 0.085 mm, and the top gear socket coned
    Parity with the web generator's 2026-09-25 changes (a56c6af, 5848fd3). Only
    the Embosser Version 2 file and its MakerWorld copy change; the Version 1
    files are untouched.
    - [Version 2 Keyed Cutouts]: key_clearance_a1_mm / _b1_mm 0.075,
    key_clearance_a2_mm / _b2_mm 0.085 - Brennen's numbers after three printed
    rounds (cylinders on Bambu Studio 0.12 mm Fine Detail, gears on 0.2 mm
    Strength; web decision D-K4). Whole steps of 0.005 (15 and 17).
    - Fused roller: V2_TOP_GEAR_SOCKET_A/B = [7.0, 5.2, 1.5] / [5.0, 3.2, 1.5]
    (measured off the gear assets: bore, rim at the floor vertex, floor above
    the top face) an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
    [Braille_Cylinder_STL_Generator_EmbosserV2.scad, Braille_Cylinder_STL_Generator_MakerWorld_v2.scad]
2026-09-26 docs: the fused roller's support-free printing in the README, headers and Gears note
    Documentation pass after 2.11.0's changes (defaults, top-socket cone):
    - README.md: the fused-roller paragraph says how it prints support-free with
    the bottom gear on the build plate (0.65 mm chamfered foot, 2 mm axis
    vent, both gear sockets coned to it - bottom since 2.10.0, top since
    2.11.0).
    - Both Version 2 file headers: the Integrated Gears bullet carries the same
    sentence (above the marker in both files).
    - [Gears] tab description: "its gear sockets are vented and self-supporting"
    now that both ends are coned (Customizer-visible; still a draft awaiting
    Brennen's sign-off, recorded in the re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
    [Braille_Cylinder_STL_Generator_EmbosserV2.scad, Braille_Cylinder_STL_Generator_MakerWorld_v2.scad]
2026-09-26 feat(v2): all four key clearance dials default to 0.075 mm
    Parity with the web generator's decision D-K6 (2026-09-26): key_clearance_a2_mm
    and key_clearance_b2_mm come down from 0.085 to 0.075, so every Version 2
    standard key hole ships at 0.075 mm per side. Both Version 2 files (the
    MakerWorld copy's tab too), the tests' per-plate defaults and tab pin, the
    parameter mapping, README, listing draft, the gears-off fixture notes and
    CHANGELOG [Unreleased].
    Checks: ruff clean; pytest 387 passed; headless renders of both Version 2
    files with no WARNING/ERROR, Status NoError, STL written.
    Claude-Session: https://claude.ai/code/session_01YB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
    [Braille_Cylinder_STL_Generator_EmbosserV2.scad, Braille_Cylinder_STL_Generator_MakerWorld_v2.scad]
2026-09-29 strings(v2): Customizer wording signed off by Brennen (2026-09-28)
    Asked one by one and recorded in his decisions file. Both Version 2 files
    (the desktop file and its MakerWorld copy); no geometry changes.
    - S-O1, the [Gears] tab description (desktop file only; the MakerWorld
    copy hides the switch): "Print bottom gear down with supports off."
    - S-O2, the indicator_mode description's last sentence: "Tactile arrows
    are the default for Version 2, as in the web app. Choose Visual for
    letter and triangle markers."
    - S-K7, each key clearance dial's description: "Gear A1, the top of
    Cylinder A: room around its peg, per side. Raise if it binds, lower if
    loose." (the gear and end vary).
    -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
    [Braille_Cylinder_STL_Generator_EmbosserV2.scad, Braille_Cylinder_STL_Generator_MakerWorld_v2.scad]
2026-09-29 fix(gears): Version 1 gear assets regenerated from Brennen's Version 1 holders
    assets/gears_a.stl and gears_b.stl are regenerated from the web repo's
    new gears_{a,b}.bin (scripts/derive_gear_assets.py, 2026-09-28): the
    gear rings of his Version 1 gear holders, cut free of the boss and
    seated on the barrel end, instead of the 2026-08-24 sample gears whose
    Cylinder B gears carry the newer design's smaller hub (a 9 mm bore where
    the Version 1 housing pin needs the 14 mm pocket) - found by his print.
    Teeth, meshing, the 72 mm roller and the [Gears] switch are unchanged.
    tests/test_gear_assets.py and tests/test_gear_rollers_scad.py count
    teeth in a 1 mm slice at the chevron apex (the whole-band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
    [gears_a.stl, gears_b.stl]
2026-10-01 feat(gears): Version 1 fused roller vent and self-supporting gear sockets
    Parity with the web generator's change of the same day (2026-09-30,
    Brennen's approved plan): with integrated_gears On, the Version 1 roller
    gets a 2 mm vent along its axis and a 45 degree cone at the blind end of
    each gear's housing-pin socket, subtracted last in both plate modules -
    Version 2's v9 change, ported - so it prints bottom gear down with no
    support inside the sockets and comes off the embosser's pin without a
    vacuum.
    - Constants mirror app/geometry/gears.py (V1_GEAR_SOCKET_A/B,
    V1_TOP_GEAR_SOCKET_A/B measured off the assets, V1_VENT_*,
    V1_SOCKET_CONE_*), with asserts: a 45 degree taper the cone can st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
    [Braille_Cylinder_STL_Generator.scad, Braille_Cylinder_STL_Generator_MakerWorld_v1.5.scad]
2026-10-01 docs: Seam Offset says what it does; the MakerWorld quick start describes the embosser's rollers
    Parity with the web generator's help review of 2026-09-30 and Brennen's
    decisions of 2026-10-01.
    - seam_offset_degrees turns only the polygonal cutout (cylinder_shell's
    cutout_rotate_deg); the dots never take it. Its Customizer text now uses
    the web app's signed wording, S-SO1: "Turns the polygonal cutout around
    the cylinder's axis. The braille does not move." (both Version 1 files;
    tests/parameter_mapping.json follows), and the note above Y Adjust in all
    four model files no longer tells users to turn the braille with it. The
    README's Dots Don't Align tip, docs/PARAMETER_MAPPING.md a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
    [Braille_Cylinder_STL_Generator.scad, Braille_Cylinder_STL_Generator_EmbosserV2.scad, Braille_Cylinder_STL_Generator_MakerWorld_v1.5.scad, Braille_Cylinder_STL_Generator_MakerWorld_v2.scad]
2026-10-01 docs(release): 2.11.0 release notes
    Cut on Brennen's word (2026-10-01, "Prepare all; I merge") after he
    approved the program state on 2026-09-30 following develop and 3D print
    testing. Parity with the web generator through 2026-10-01. Rides: one key
    clearance dial per gear, all four 0.075 mm (ec4f279, a57d116, d7cc6f6); the
    coned top gear socket (a57d116, printed and fitting); the Customizer
    sign-offs (e2bfba9); the Version 1 gears from his Version 1 holders
    (563c179); the Version 1 fused roller's vent and self-supporting sockets
    (f9fa82d, print-tested); and the Seam Offset wording and MakerWorld quick
    start (94ab2b2). README version 2.11.0, last updated 2026-10-01.
    Verified before this com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
2026-10-03 docs(v2): fact-check the MakerWorld listing draft against v2.11.0
    Every number and parameter name in the Version 2 listing draft was checked
    against Braille_Cylinder_STL_Generator_EmbosserV2.scad and its MakerWorld
    copy at v2.11.0; all were true. Two additions, both still DRAFT:
    - "How to use it" gains a step 4: row markers default to the tactile seam
    arrow (indicator_mode = "Tactile" since v2.10.0), and Visual gives letter
    and triangle markers. The later steps are renumbered 5 to 7.
    - Shot 4's alt text describes today's Customizer panel (the four Line
    fields above Card Sides, Cylinders to Generate, Row Indicator Style and
    Card Thickness) instead of a plate-type choice, and its shot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
2026-10-03 docs(v2): the MakerWorld listing text is signed (2026-10-02)
    Brennen signed every block of the Version 2 listing draft on 2026-10-02,
    with three wording choices of his own:
    - the compatibility warning names "the v7.2 gear set, also called v8";
    - step 4 says Visual markers are for single-sided cards (in double-sided
    mode the file forces the tactile arrow);
    - shot 1's alt text says one cylinder carries raised dots and the other
    matching recesses (a single-sided Counter Plate has no raised dots), and
    no longer names a filament colour.
    Each block is marked SIGNED (2026-10-02); the Full description notes that
    its inset was signed on 2026-08-28. The box at the top says the text is
    signed a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
2026-10-09 feat(customizer): the web app's layout, one-line descriptions, and a fixed-gear MakerWorld upload
    Found by Brennen's MakerWorld test of the desktop Version 2 file on
    2026-10-07: expert dials sat beside the braille text, descriptions
    showed only their last line, and the fixed gears never appeared,
    because MakerWorld cannot load assets/v2_gears_{a,b}.stl.
    - All four model files lay out their dials in the web app's top-down
    order: Gears and Card Sides, the front text, the back text (a new
    Back of Card - Pre-Translated Braille tab), then one "Expert Mode - "
    tab per web Expert Mode submenu (Cylinders to Generate, Card
    Thickness, Row Indicator Style, Shape Selection, Braille Spacing,
    B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
2026-10-09 feat(rows): rows that would run off the card or the cylinder stop the model
    Brennen's decision (2026-10-09): the OpenSCAD models get the web
    generator's rows-fit check (its app/validation.py
    validate_braille_rows_fit, from app/geometry_spec.py
    braille_rows_extent; web PR #116). One identical block in the four model
    files, and the regenerated fixed-gear upload: rows are centred on the
    height and moved by braille_y_adjust; the outer dots reach the dot
    spacing plus the widest dot or bowl radius (seam_channel_footprint_mm's
    radius); the per-row tactile arrows are measured on the counter plate's
    recess, grown by the clearance (or the gear weld) with a sharp tip
    (6.02 mm above the row centre at th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
2026-10-10 docs(release): 2.12.0 release notes
    Cut on Brennen's word (2026-10-09, "Prepare v2.12.0") after he merged PR #5.
    Parity with the web generator through 2026-10-09. Rides: the rows-fit check
    (4029fdf; the web generator's own sentences, rows on the card and arrows on
    the barrel), the Customizer in the web app's layout with one-line
    descriptions, and the fixed-gear MakerWorld upload for Embosser Version 2
    (e1fb532). README version 2.12.0, last updated 2026-10-09.
    Verified before this commit, on develop 99783f6: full suite 432 passed,
    cross-platform validation 74 passed (pytest tests/cross_platform_validation.py
    --skip-cloudcompare), scripts/scad-check.ps1 passes on all four model files;
    after t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
